rice-eclipse/Real-Time-Rocket/Neutro_documentation/Neutro Kicad Symbol Footprint/畫面截取 2022-11-02 at 14.26.27.png

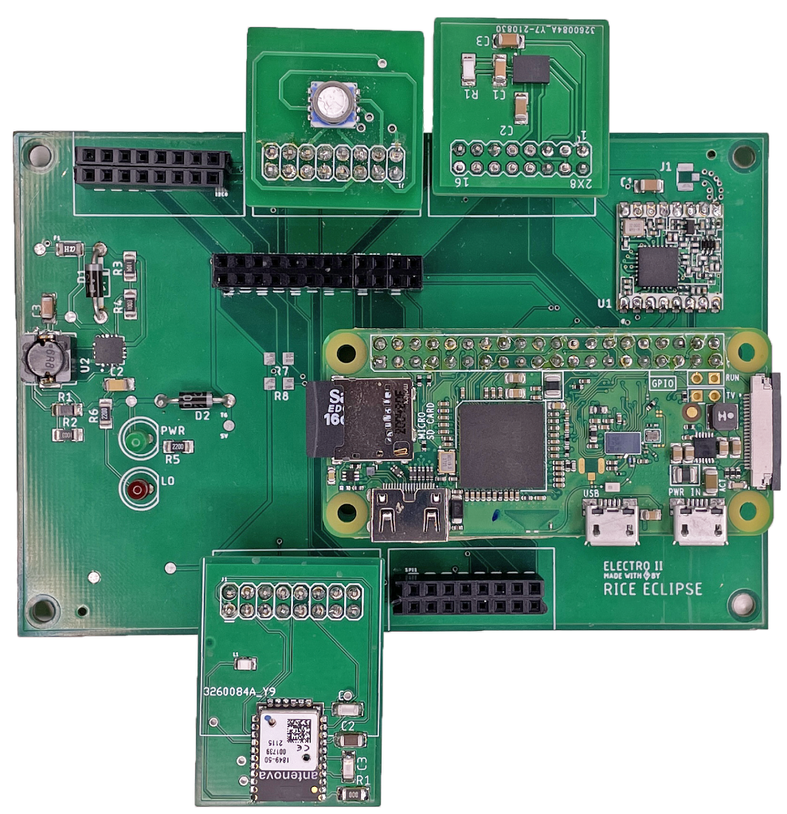
Neutro_documentation/Neutro Kicad Symbol Footprint/畫面截取 2022-11-02 at 14.26.27.png
