rice-eclipse/Real-Time-Rocket/Neutro_documentation/主題.jpeg

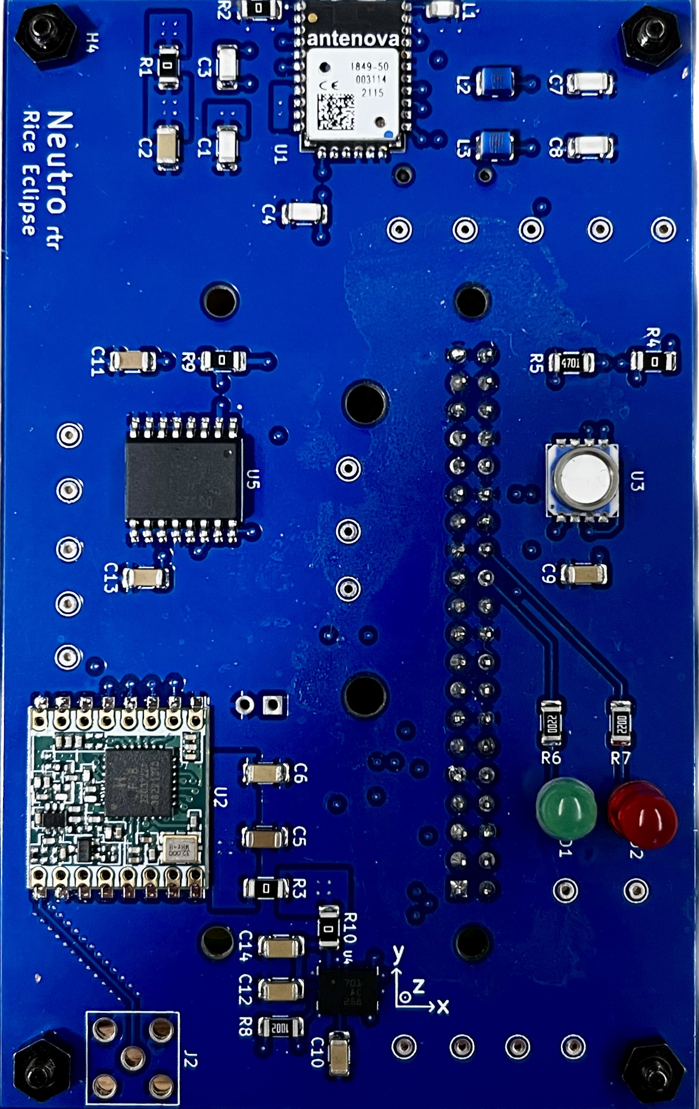
Neutro_documentation/主題.jpeg
