rice-eclipse/Real-Time-Rocket/README.md

# Neutro
Third iteration of Rice Eclipse's student developed flight computer Real Time Rocket. Includes PCB design files and python scripts used to operate Neutro sensors and transmit data to the ground station NARWAL.
