rice-eclipse/Real-Time-Rocket/Neutro_documentation/GPS/畫面截取 2023-03-22 at 22.20.59.png

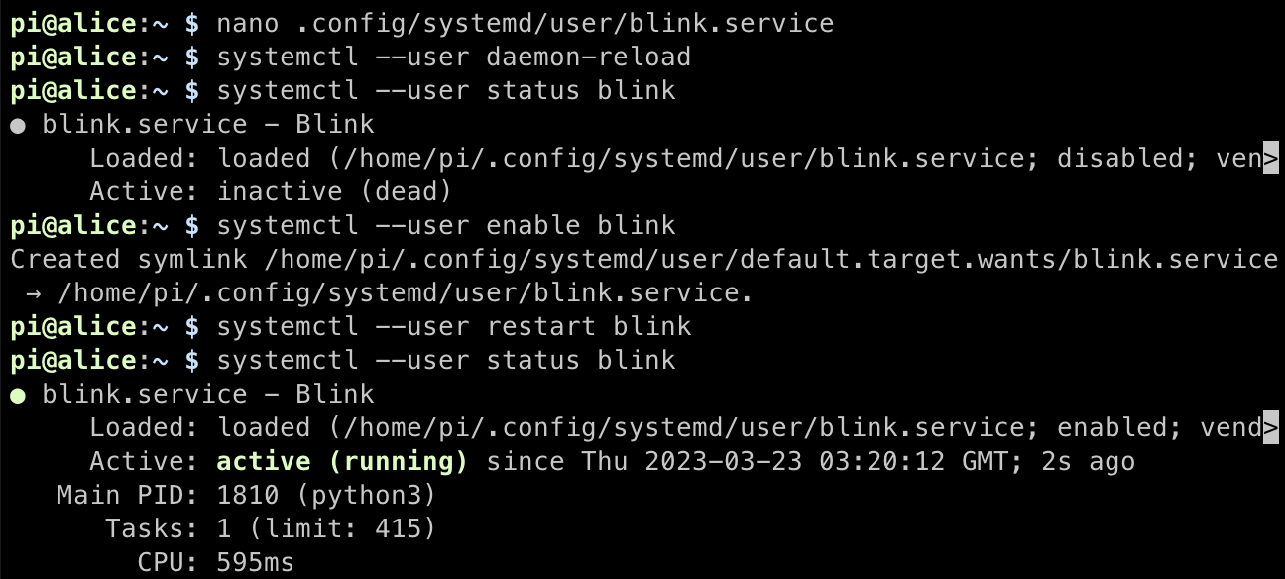
Neutro_documentation/GPS/畫面截取 2023-03-22 at 22.20.59.png
