rice-eclipse/Real-Time-Rocket/Neutro_documentation/JLC Order Settings/screentshot1.png

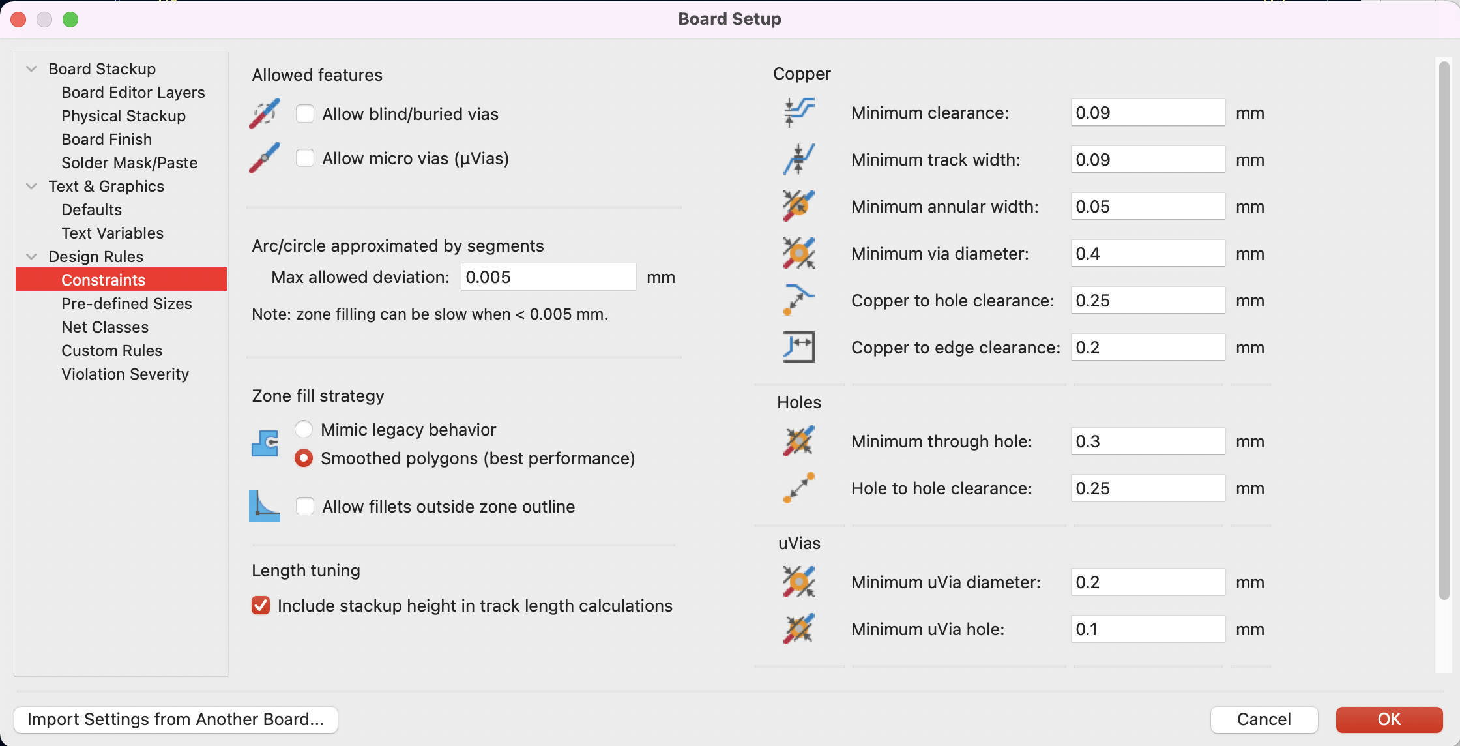
Neutro_documentation/JLC Order Settings/screentshot1.png
