rice-eclipse/Real-Time-Rocket/Neutro_documentation/JLC Order Settings/screentshot3.png

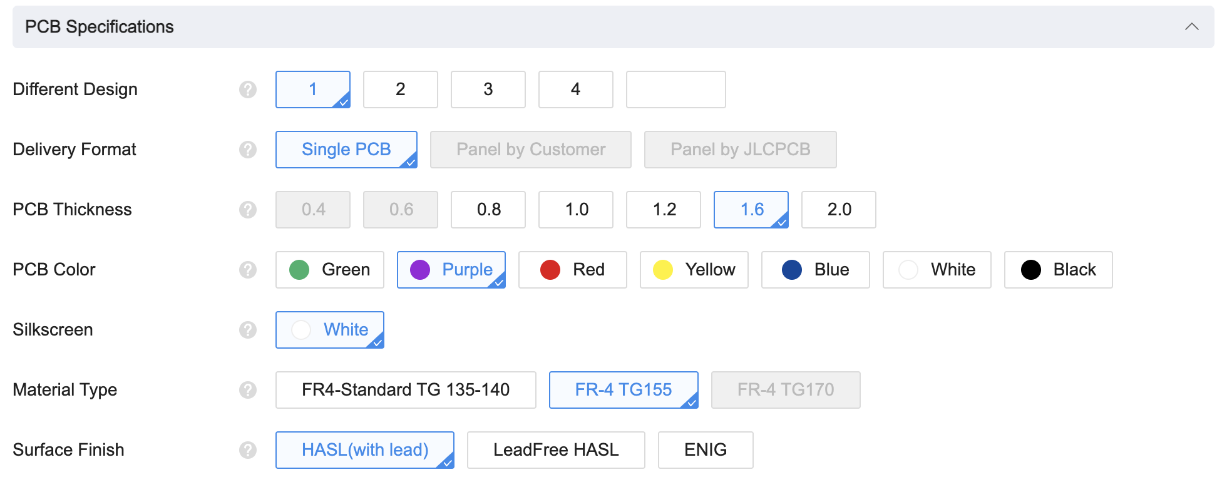
Neutro_documentation/JLC Order Settings/screentshot3.png
