rice-eclipse/Real-Time-Rocket/Neutro_documentation/JLC Order Settings/screentshot4.png

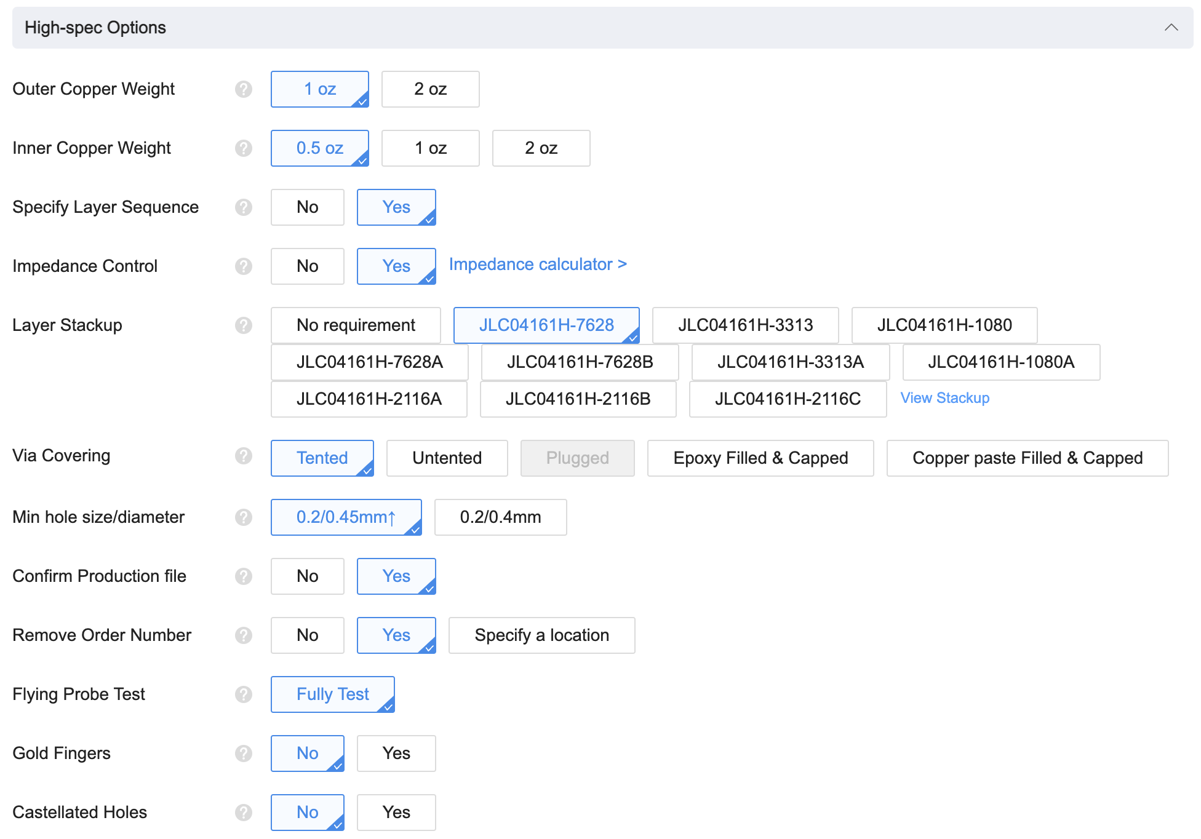
Neutro_documentation/JLC Order Settings/screentshot4.png
