rice-eclipse/Real-Time-Rocket/Neutro_documentation/Neutro Kicad Symbol Footprint/BNO080/BNO080.step

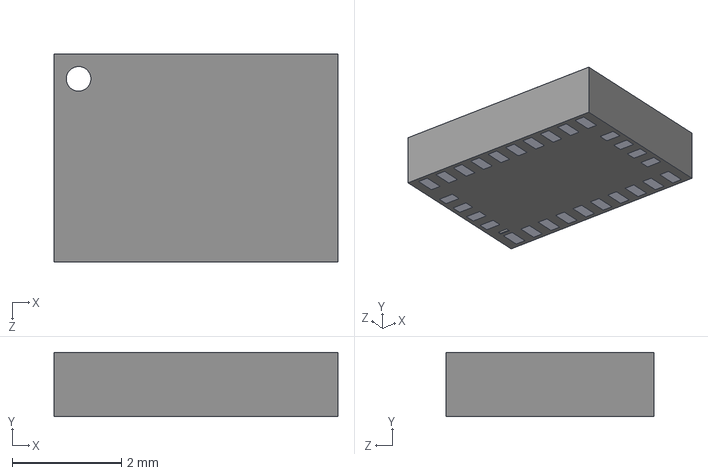
[picture p7: CAD file, 2023-06-26]
Neutro_documentation/Neutro Kicad Symbol Footprint/BNO080/BNO080.step
5.20 x 1.18 x 3.80 mm
