rice-eclipse/Real-Time-Rocket/Neutro_documentation/Neutro Kicad Symbol Footprint/DS3231M_TRL/DS3231M_TRL.step

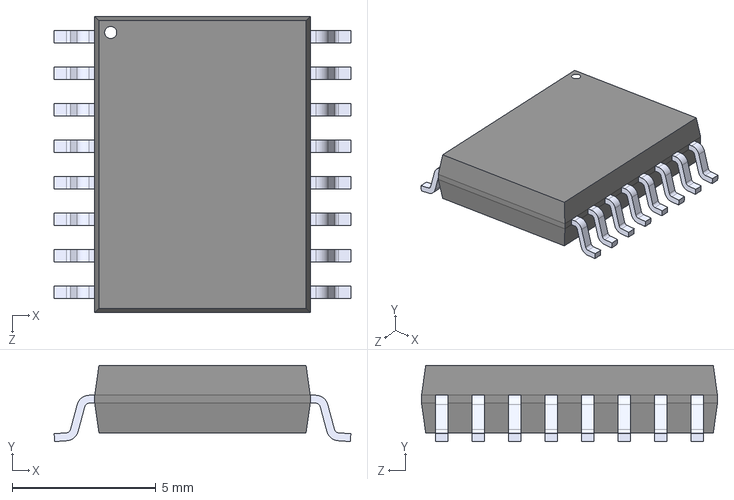
[picture p8: CAD file, 2023-01-18]
Neutro_documentation/Neutro Kicad Symbol Footprint/DS3231M_TRL/DS3231M_TRL.step
10.3 x 2.65 x 10.3 mm
