rice-eclipse/Real-Time-Rocket/Neutro_documentation/Neutro Kicad Symbol Footprint/RFM98W-433S2 copy/RFM98W-433S2.step

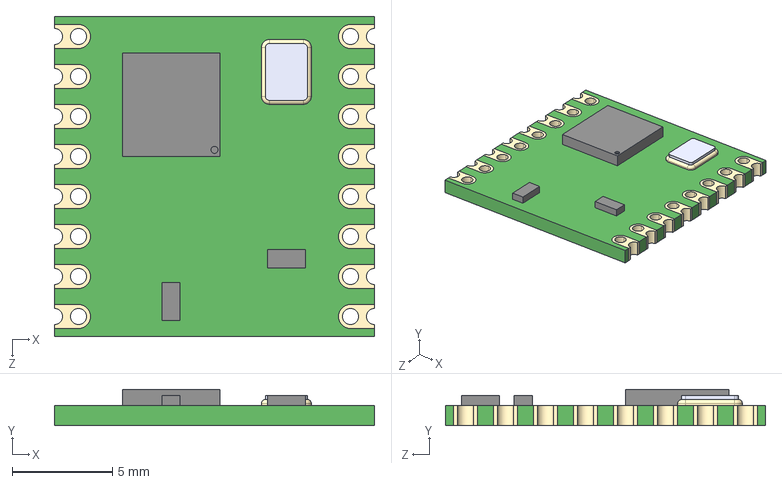
[picture p9: CAD file, 2023-06-26]
Neutro_documentation/Neutro Kicad Symbol Footprint/RFM98W-433S2 copy/RFM98W-433S2.step
16.0 x 1.80 x 16.0 mm
