rice-eclipse/Real-Time-Rocket/Neutro_documentation/Neutro Kicad Symbol Footprint/S8411-45R/S8411-45R.step

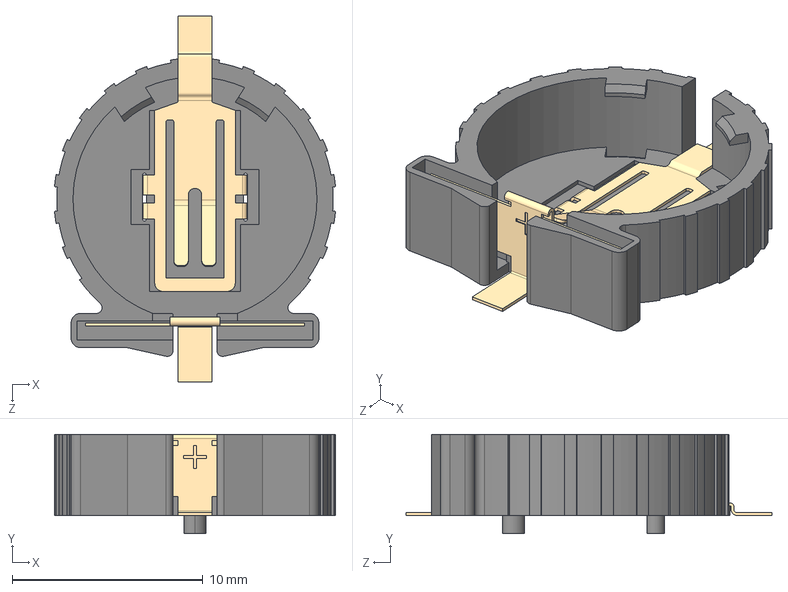
[picture p10: CAD file, 2023-06-26]
Neutro_documentation/Neutro Kicad Symbol Footprint/S8411-45R/S8411-45R.step
14.7 x 5.20 x 19.2 mm
