rice-eclipse/Real-Time-Rocket/Neutro_PCB/Neutro_3D_Files/BNO085.stp

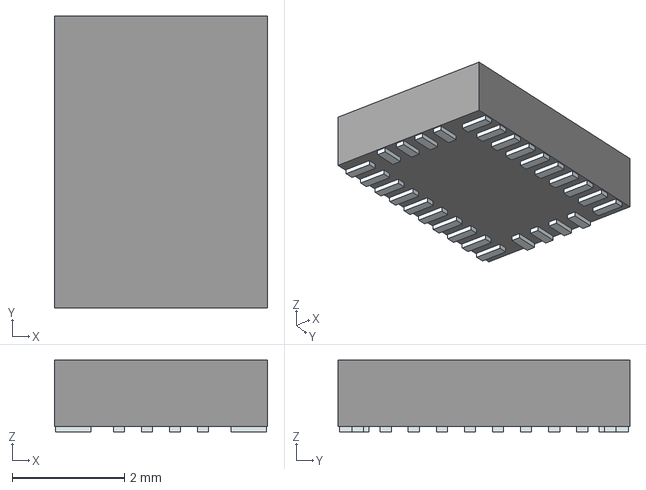
[picture p11: CAD file, 2023-01-18]
Neutro_PCB/Neutro_3D_Files/BNO085.stp
3.80 x 5.20 x 1.28 mm
Pins
