rice-eclipse/Real-Time-Rocket/Neutro_PCB/Neutro_3D_Files/RFM95W-868S2--3DModel-STEP-56544.step

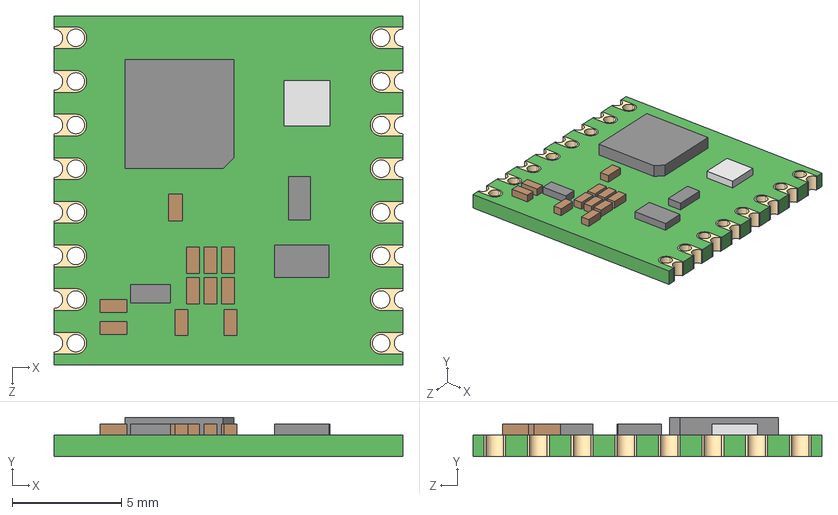
[picture p12: CAD file, 2023-01-18]
Neutro_PCB/Neutro_3D_Files/RFM95W-868S2--3DModel-STEP-56544.step
16.0 x 1.80 x 16.0 mm
