rice-eclipse/Real-Time-Rocket/Neutro_documentation/Neutro Kicad Symbol Footprint/TPS61092RSAR/TPS61092RSAR.step

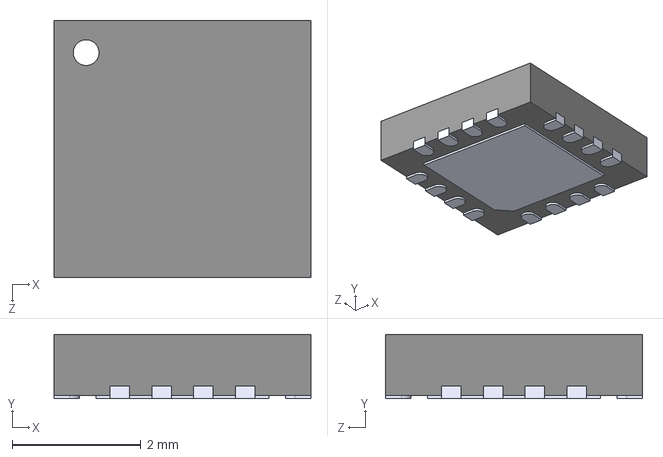
[picture p13: CAD file, 2023-06-26]
Neutro_documentation/Neutro Kicad Symbol Footprint/TPS61092RSAR/TPS61092RSAR.step
4.00 x 1.00 x 4.00 mm
