rice-eclipse/Real-Time-Rocket/Neutro_PCB/Neutro_Extra_Lib/M20050-1_Lib/M20050-1/3D/M20050-1.stp

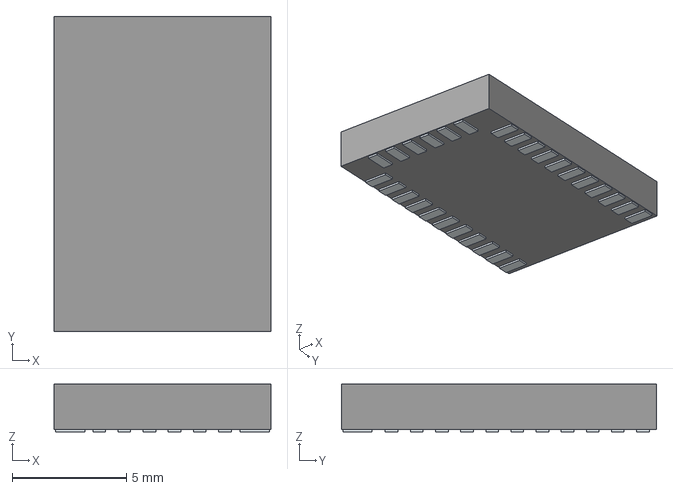
[picture p14: CAD file, 2023-01-18]
Neutro_PCB/Neutro_Extra_Lib/M20050-1_Lib/M20050-1/3D/M20050-1.stp
9.50 x 13.8 x 2.10 mm
Pins
