rice-eclipse/Real-Time-Rocket/Neutro_PCB/Neutro_Extra_Lib/MS580330BA01-00_Lib/MS580330BA01-00/3D/MS580330BA01-00.stp

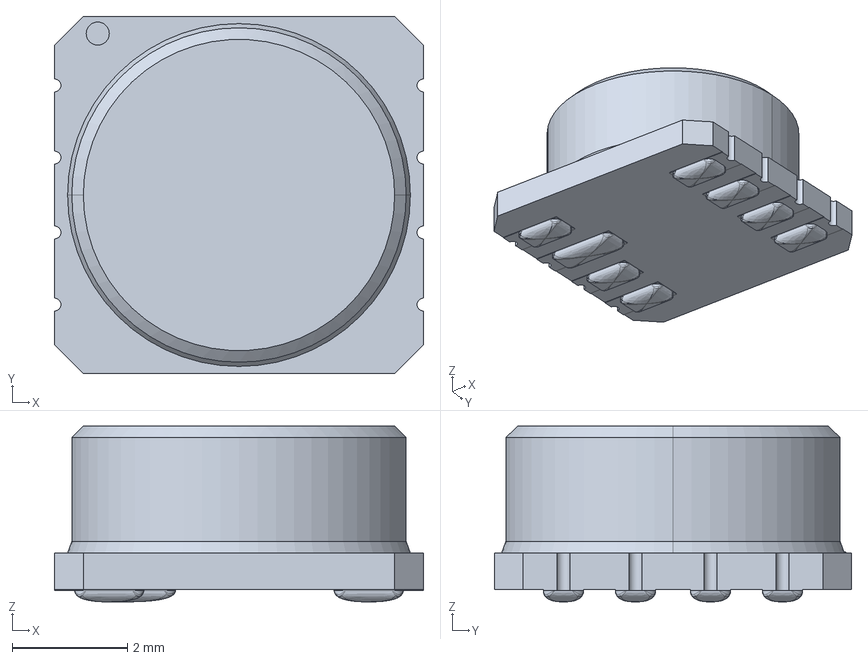
[picture p15: CAD file, 2023-01-18]
Neutro_PCB/Neutro_Extra_Lib/MS580330BA01-00_Lib/MS580330BA01-00/3D/MS580330BA01-00.stp
6.40 x 6.20 x 3.05 mm
