rice-eclipse/Real-Time-Rocket/(list of files, cad)

Other CAD files:
Neutro_PCB/Neutro_3D_Files/BATT-S8411-45R.step
Neutro_PCB/Neutro_Extra_Lib/BNO085_Lib/BNO085/Allegro/bno085.psm
Neutro_PCB/Neutro_Extra_Lib/BNO085_Lib/BNO085/DEHDL/bno085/chips/chips.prt
Neutro_PCB/Neutro_Extra_Lib/M20050-1_Lib/M20050-1/Allegro/m200501.psm
Neutro_PCB/Neutro_Extra_Lib/M20050-1_Lib/M20050-1/DEHDL/m20050_1/chips/chips.prt
Neutro_PCB/Neutro_Extra_Lib/MS580330BA01-00_Lib/MS580330BA01-00/Allegro/ms580330ba0100.psm
Neutro_PCB/Neutro_Extra_Lib/MS580330BA01-00_Lib/MS580330BA01-00/DEHDL/ms580330ba01_00/chips/chips.prt
