rice-eclipse/Real-Time-Rocket/(list of files, drawings)

Other design files:
Neutro_PCB/Neutro_Extra_Lib/BNO085_Lib/BNO085/Altium/BNO085.PcbLib
Neutro_PCB/Neutro_Extra_Lib/BNO085_Lib/BNO085/Altium/BNO085.SchLib
Neutro_PCB/Neutro_Extra_Lib/M20050-1_Lib/M20050-1/Altium/M20050-1.SchLib
Neutro_PCB/Neutro_Extra_Lib/M20050-1_Lib/M20050-1/Altium/M200501.PcbLib
Neutro_PCB/Neutro_Extra_Lib/MS580330BA01-00_Lib/MS580330BA01-00/Altium/MS580330BA01-00.SchLib
Neutro_PCB/Neutro_Extra_Lib/MS580330BA01-00_Lib/MS580330BA01-00/Altium/MS580330BA0100.PcbLib
