rice-eclipse/Real-Time-Rocket/Neutro_PCB/Neutro_v1.kicad_pcb

## KiCad design Neutro_PCB/Neutro_v1.kicad_pcb (2023-01-22)

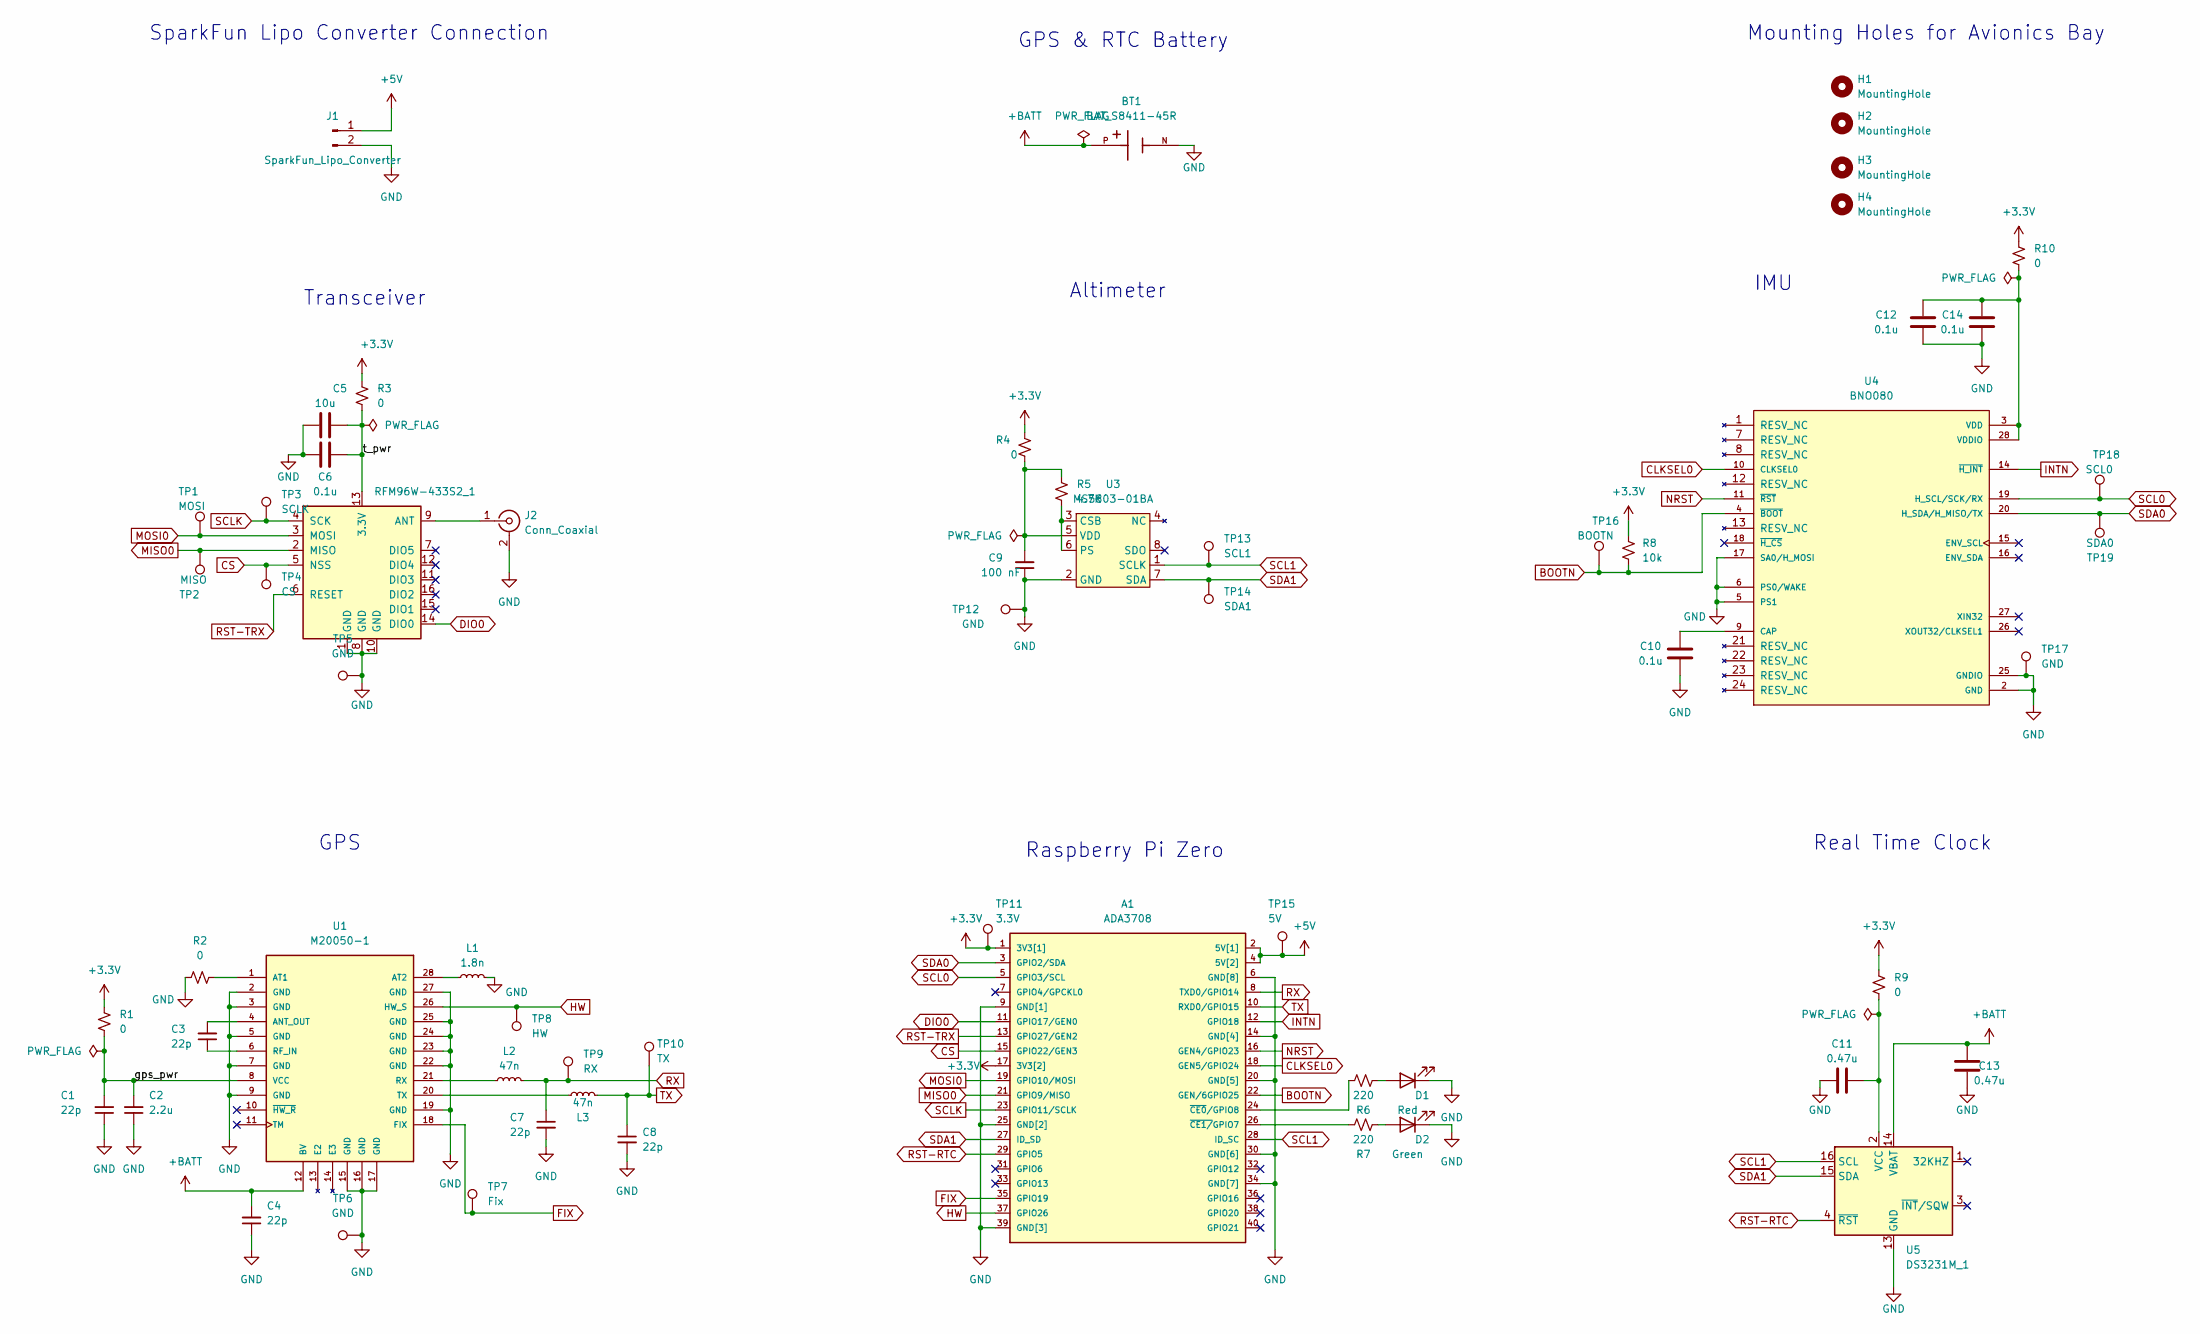
[picture p16: schematic Neutro_v1.kicad_sch, Neutro]

Parts:
A1: ADA3708; ADA3708_RPI-ZERO
BT1: BAT_S8411-45R
C1, C3, C4, C7, C8: 22p; C_1206_3216Metric
C2: 2.2u; C_1206_3216Metric
C5: 10u; C_1206_3216Metric
C6, C10, C12, C14: 0.1u; C_1206_3216Metric
C9: 100 nF; C_1206_3216Metric
C11, C13: 0.47u; C_1206_3216Metric
D1: Red; LED_D3.0mm
D2: Green; LED_D3.0mm
H1, H2, H3, H4: MountingHole; MountingHole_2.5mm
J1: SparkFun_Lipo_Converter; Sparkfun_Lipo_Converter
J2: Conn_Coaxial; SMA_Amphenol_132203-12_Horizontal
L1: 1.8n; L_0805_2012Metric
L2, L3: 47n; L_1008_2520Metric
R1, R2, R3, R4, R9, R10: 0; R_1206_3216Metric
R5: 4.7K; R_1206_3216Metric
R6, R7: 220; R_1206_3216Metric
R8: 10k; R_1206_3216Metric
TP1: MOSI; TestPoint_THTPad_D1.5mm_Drill0.7mm
TP2: MISO; TestPoint_THTPad_D1.5mm_Drill0.7mm
TP3: SCLK; TestPoint_THTPad_D1.5mm_Drill0.7mm
TP4: CS; TestPoint_THTPad_D1.5mm_Drill0.7mm
TP5, TP6, TP12, TP17: GND; TestPoint_THTPad_D1.5mm_Drill0.7mm
TP7: Fix; TestPoint_THTPad_D1.5mm_Drill0.7mm
TP8: HW; TestPoint_THTPad_D1.5mm_Drill0.7mm
TP9: RX; TestPoint_THTPad_D1.5mm_Drill0.7mm
TP10: TX; TestPoint_THTPad_D1.5mm_Drill0.7mm
TP11: 3.3V; TestPoint_THTPad_D1.5mm_Drill0.7mm
TP13: SCL1; TestPoint_THTPad_D1.5mm_Drill0.7mm
TP14: SDA1; TestPoint_THTPad_D1.5mm_Drill0.7mm
TP15: 5V; TestPoint_THTPad_D1.5mm_Drill0.7mm
TP16: BOOTN; TestPoint_THTPad_D1.5mm_Drill0.7mm
TP18: SCL0; TestPoint_THTPad_D1.5mm_Drill0.7mm
TP19: SDA0; TestPoint_THTPad_D1.5mm_Drill0.7mm
U1: M20050-1; PARTREV M20050-1-PS-2.01
U2: RFM96W-433S2_1; HOPERF_RFM9XW_SMD
U3: MS5803-01BA; MS5803-01BA_Miniature_Altimeter_Module
U4: BNO080; BNO085; PARTREV 1.6
U5: DS3231M_1; DS3231M

Connections:
+3.3V: A1.1 (3V3[1]), A1.17 (3V3[2]), R1.1, R3.1, R4.1, R8.1, R9.1, R10.1, TP11.1
+5V: A1.2 (5V[1]), A1.4 (5V[2]), J1.1, TP15.1
+BATT: BT1.P, C4.2, C13.1, U1.12 (BV), U5.14 (VBAT)
/gps_pwr: C1.2, C2.2, R1.2, U1.8 (VCC)
/t_pwr: C5.2, C6.2, R3.2, U2.13 (3.3V)
BOOTN: A1.22 (GEN/6GPIO25), R8.2, TP16.1, U4.4 (~BOOT)
CLKSEL0: A1.18 (GEN5/GPIO24), U4.10 (CLKSEL0)
CS: A1.15 (GPIO22/GEN3), TP4.1, U2.5 (NSS)
DIO0: A1.11 (GPIO17/GEN0), U2.14 (DIO0)
FIX: A1.35 (GPIO19), TP7.1, U1.18 (FIX)
GND: A1.6 (GND[8]), A1.9 (GND[1]), A1.14 (GND[4]), A1.20 (GND[5]), A1.25 (GND[2]), A1.30 (GND[6]), A1.34 (GND[7]), A1.39 (GND[3]), BT1.N, C1.1, C2.1, C4.1, C5.1, C6.1, C7.2, C8.2, C9.1, C10.1, C11.1, C12.1, C13.2, C14.1, D1.1 (K), D2.1 (K), J1.2, J2.2 (Ext), L1.1, R2.1, TP5.1, TP6.1, TP12.1, TP17.1, U1.2 (GND), U1.3 (GND), U1.5 (GND), U1.7 (GND), U1.9 (GND), U1.15 (GND), U1.16 (GND), U1.17 (GND), U1.19 (GND), U1.22 (GND), U1.23 (GND), U1.24 (GND), U1.25 (GND), U1.27 (GND), U2.1 (GND), U2.8 (GND), U2.10 (GND), U3.2 (GND), U4.2 (GND), U4.5 (PS1), U4.6 (PS0/WAKE), U4.17 (SA0/H_MOSI), U4.25 (GNDIO), U5.5 (GND), U5.6 (GND), U5.7 (GND), U5.8 (GND), U5.9 (GND), U5.10 (GND), U5.11 (GND), U5.12 (GND), U5.13 (GND)
HW: A1.37 (GPIO26), TP8.1, U1.26 (HW_S)
INTN: A1.12 (GPIO18), U4.14 (~H_INT)
MISO0: A1.21 (GPIO9/MISO), TP2.1, U2.2 (MISO)
MOSI0: A1.19 (GPIO10/MOSI), TP1.1, U2.3 (MOSI)
NRST: A1.16 (GEN4/GPIO23), U4.11 (~RST)
unnamed: A1.24 (~CE0/GPIO8), R6.1
unnamed: A1.26 (~CE1/GPIO7), R7.1
unnamed: C3.1, U1.6 (RF_IN)
unnamed: C3.2, U1.4 (ANT_OUT)
unnamed: C9.2, R4.2, R5.1, U3.5 (VDD)
unnamed: C10.2, U4.9 (CAP)
unnamed: C11.2, R9.2, U5.2 (VCC)
unnamed: C12.2, C14.2, R10.2, U4.3 (VDD), U4.28 (VDDIO)
unnamed: D1.2 (A), R6.2
unnamed: D2.2 (A), R7.2
unnamed: J2.1 (In), U2.9 (ANT)
unnamed: L1.2, U1.28 (AT2)
unnamed: L2.1, U1.21 (RX)
unnamed: L3.1, U1.20 (TX)
unnamed: R2.2, U1.1 (AT1)
unnamed: R5.2, U3.3 (CSB), U3.6 (PS)
RST-RTC: A1.29 (GPIO5), U5.4 (~RST)
RST-TRX: A1.13 (GPIO27/GEN2), U2.6 (RESET)
RX: A1.8 (TXD0/GPIO14), C7.1, L2.2, TP9.1
SCL0: A1.5 (GPIO3/SCL), TP18.1, U4.19 (H_SCL/SCK/RX)
SCL1: A1.28 (ID_SC), TP13.1, U3.1 (SCLK), U5.16 (SCL)
SCLK: A1.23 (GPIO11/SCLK), TP3.1, U2.4 (SCK)
SDA0: A1.3 (GPIO2/SDA), TP19.1, U4.20 (H_SDA/H_MISO/TX)
SDA1: A1.27 (ID_SD), TP14.1, U3.7 (SDA), U5.15 (SDA)
TX: A1.10 (RXD0/GPIO15), C8.1, L3.2, TP10.1

Notes on the sheet:
IMU
Raspberry Pi Zero
GPS & RTC Battery
SparkFun Lipo Converter Connection
GPS
Altimeter
Real Time Clock
Transceiver
Mounting Holes for Avionics Bay

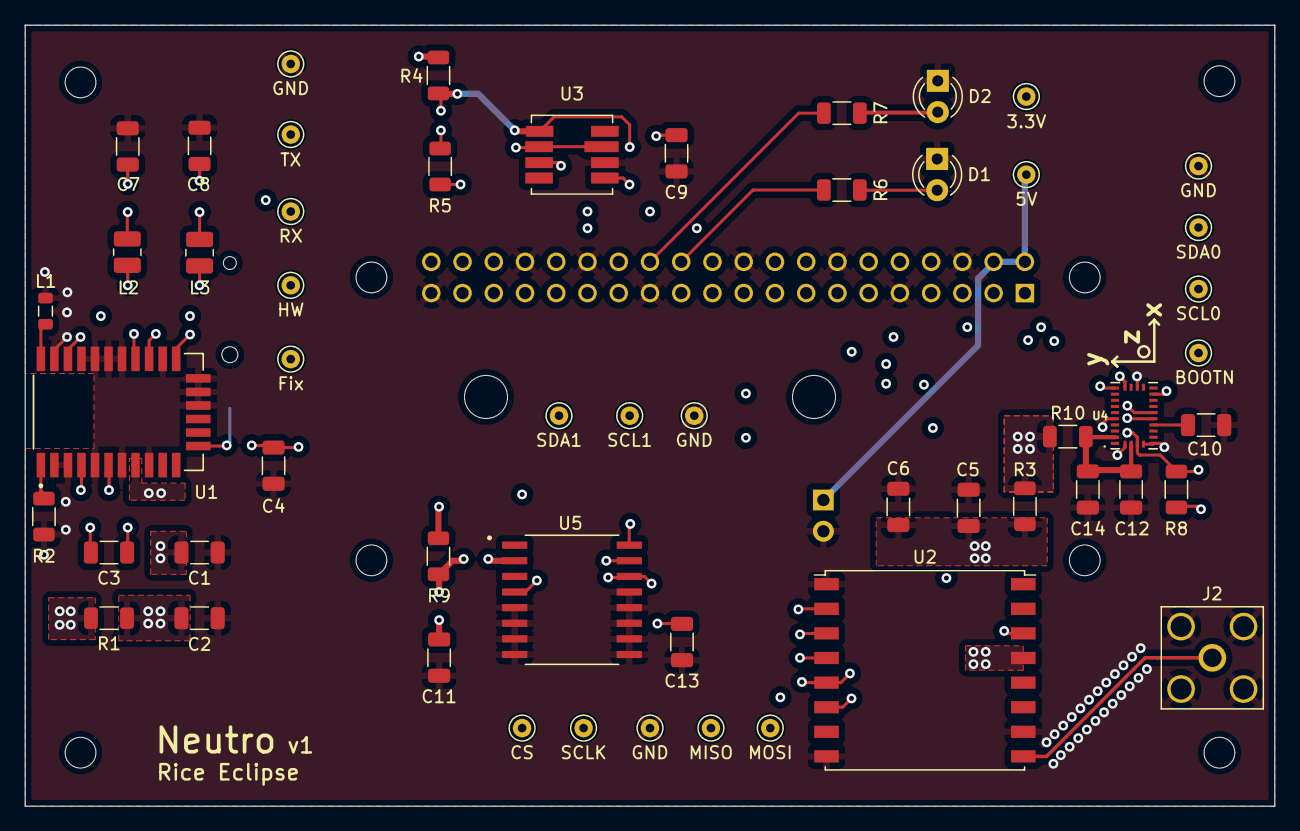
[picture p17: board Neutro_v1.kicad_pcb from above]

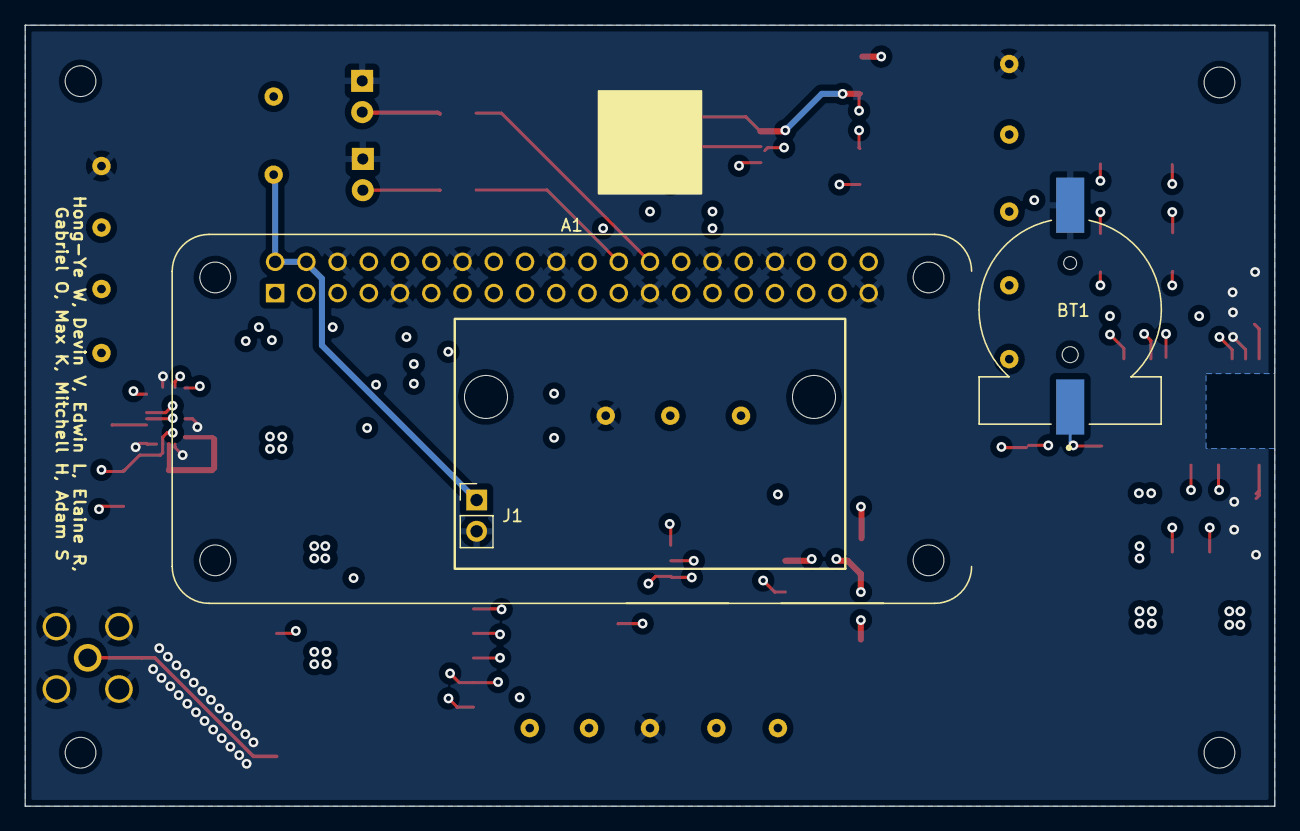
[picture p18: board Neutro_v1.kicad_pcb from below]

Board: 4 copper layers, 101.6 x 63.5 mm, 61 parts (3 on the bottom side), 41 nets.
