rice-eclipse/Real-Time-Rocket/Neutro_documentation/Neutro Kicad Symbol Footprint/Electro Transmitter Rev 1 copy.brd

## EAGLE design Neutro_documentation/Neutro Kicad Symbol Footprint/Electro Transmitter Rev 1 copy.brd (2019-08-31)

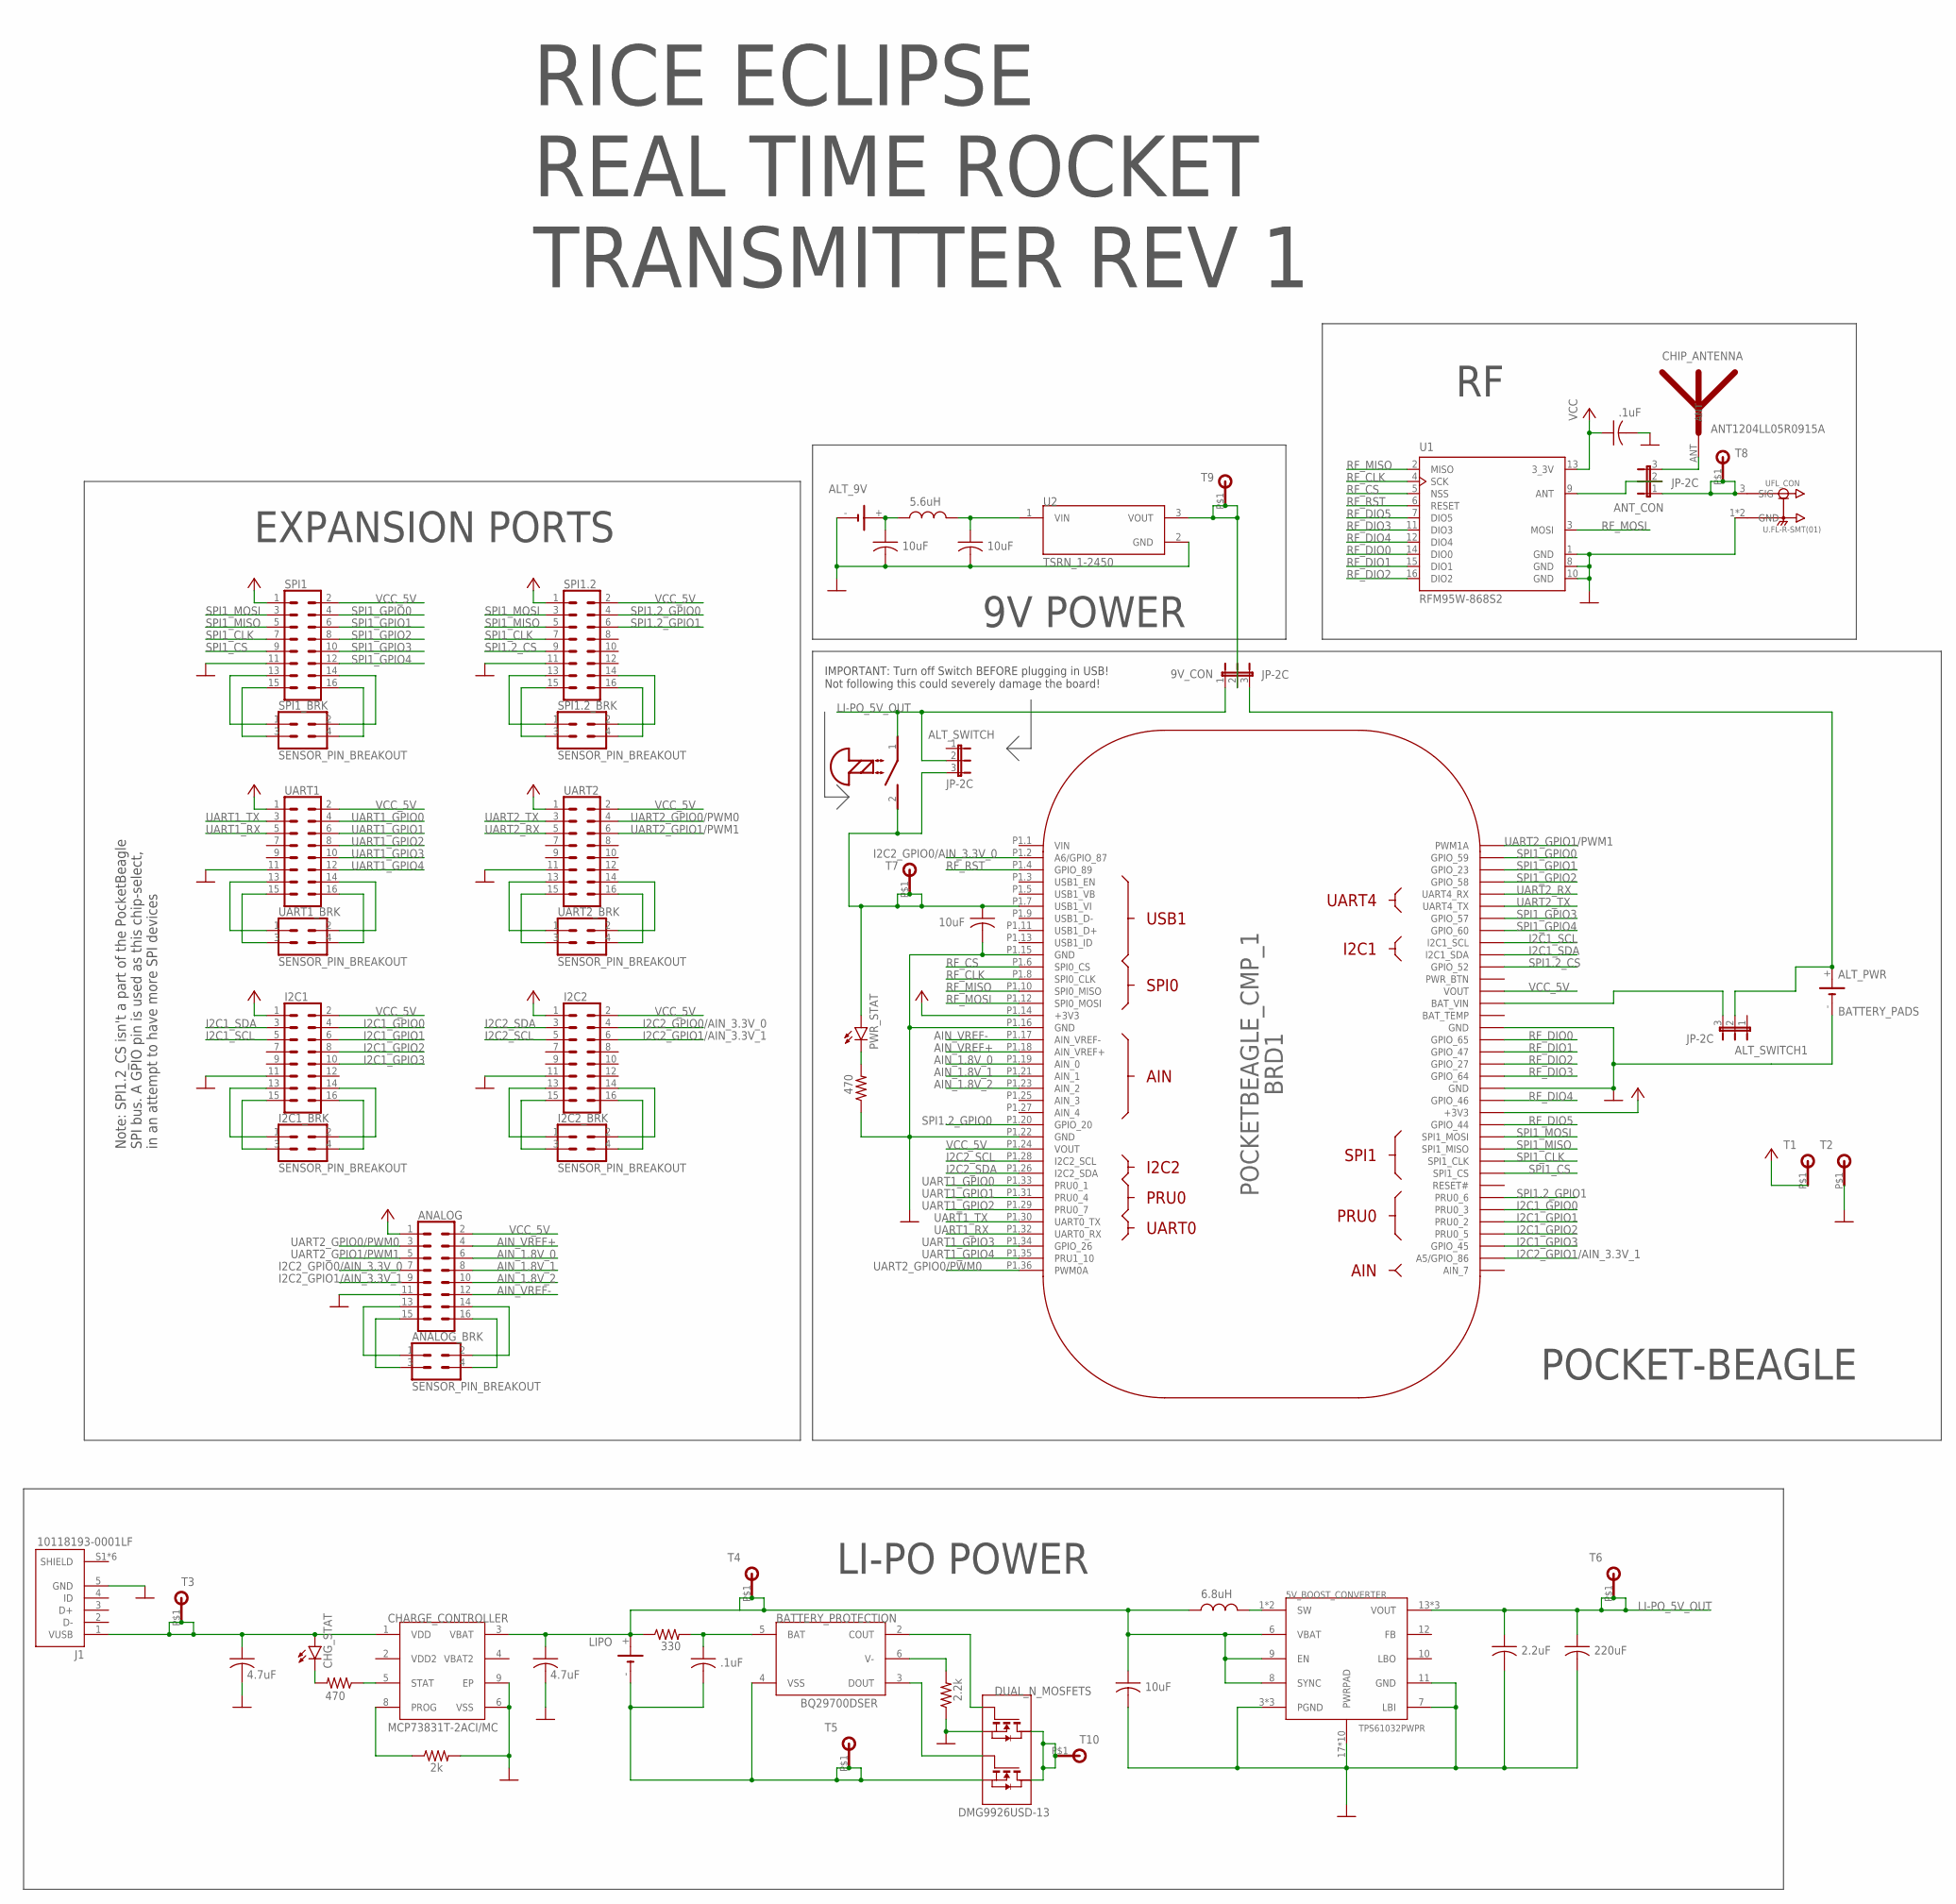
[picture p19: schematic Electro Transmitter Rev 1 copy.sch]

Parts:
5V_BOOST_CONVERTER: TPS61032PWPR; SOP65P640X110-17N
9V_C1, 9V_C2: 10uF; C1206
9V_CON: JP-2C; JP2
9V_L1: 5.6uH; L-DS75LC
ALT_9V: BATTERY_PADS; POWER_PADS
ALT_PWR: BATTERY_PADS; POWER_PADS
ALT_SWITCH, ALT_SWITCH1: JP-2C; JP2
ANALOG: 2X6 FEMALE; 2X7
ANALOG_BRK: SENSOR_PIN_BREAKOUT; 2X2
ANT_CON: JP-2C; JP2
BATTERY_PROTECTION: BQ29700DSER; SON50P150X150X80-6N
BAT_C1: .1uF; C1206
BAT_PWR: SCREW_SWITCH
BAT_R1: 330; R1206
BAT_R2: 2.2k; R1206
BRD1: POCKETBEAGLE_CMP_1; POCKETBEAGLE_CMP
CHARGE_CONTROLLER: MCP73831T-2ACI/MC; SON50P200X300X100-9N
CHG_C1, CHG_C2: 4.7uF; C1206
CHG_R1: 470; R1206
CHG_R2: 2k; R1206
CHG_STAT: LED5MM
CHIP_ANTENNA: ANT1204LL05R0915A; SMD_ANTENNA
CONV_C1: 10uF; C1206
CONV_C2: 2.2uF; C1206
CONV_C3: 220uF; C1206
CONV_L1: 6.8uH; L-DS75LC
DUAL_N_MOSFETS: DMG9926USD-13; SOIC127P600X175-8N
I2C1, I2C2: 2X6 FEMALE; 2X7
I2C1_BRK, I2C2_BRK: SENSOR_PIN_BREAKOUT; 2X2
J1: 10118193-0001LF; FCI_10118193-0001LF
LED_R_1: 470; R1206
LIPO: BATTERY_PADS; POWER_PADS
PWR_C1: 10uF; C1206
PWR_STAT: LED5MM
RF_C1: .1uF; C1206
SPI1, SPI1.2: 2X6 FEMALE; 2X7
SPI1.2_BRK, SPI1_BRK: SENSOR_PIN_BREAKOUT; 2X2
T1, T2, T3, T4, T5, T6, T7, T8, T9, T10: TEST_PAD
U1: RFM95W-868S2; XCVR_RFM95W-868S2
U2: TSRN_1-2450; CONV_TSRN_1-2433
UART1, UART2: 2X6 FEMALE; 2X7
UART1_BRK, UART2_BRK: SENSOR_PIN_BREAKOUT; 2X2
UFL_CON: U.FL-R-SMT(01); HRS_U.FL-R-SMT(01)

Connections:
9V_+: 9V_C1.1, 9V_L1.P$1 (1), ALT_9V.+
9V_VIN: 9V_C2.1, 9V_L1.P$2 (2), U2.1 (VIN)
9V_VOUT: 9V_CON.2, T9.P$1, U2.3 (VOUT)
AIN_1.8V_0: ANALOG.6, BRD1.P1.19 (AIN_0)
AIN_1.8V_1: ANALOG.8, BRD1.P1.21 (AIN_1)
AIN_1.8V_2: ANALOG.10, BRD1.P1.23 (AIN_2)
AIN_VREF+: ANALOG.4, BRD1.P1.18 (AIN_VREF+)
AIN_VREF-: ANALOG.12, BRD1.P1.17 (AIN_VREF-)
ALT_PWR_+: 9V_CON.3, ALT_PWR.+, ALT_SWITCH1.2
ANT: ANT_CON.3, CHIP_ANTENNA.ANT
BAT: BATTERY_PROTECTION.5 (BAT), BAT_C1.1, BAT_R1.2
BAT_VIN: ALT_SWITCH1.3, BRD1.P2.14 (BAT_VIN)
COUT: BATTERY_PROTECTION.2 (COUT), DUAL_N_MOSFETS.2 (G1)
DOUT: BATTERY_PROTECTION.3 (DOUT), DUAL_N_MOSFETS.4 (G2)
DRAIN: DUAL_N_MOSFETS.5 (D2), DUAL_N_MOSFETS.6 (D2), DUAL_N_MOSFETS.7 (D1), DUAL_N_MOSFETS.8 (D1), T10.P$1
GND: 5V_BOOST_CONVERTER.3 (PGND), 5V_BOOST_CONVERTER.4 (PGND), 5V_BOOST_CONVERTER.5 (PGND), 5V_BOOST_CONVERTER.7 (LBI), 5V_BOOST_CONVERTER.11 (GND), 5V_BOOST_CONVERTER.17 (PWRPAD), 5V_BOOST_CONVERTER.P$1 (PWRPAD), 5V_BOOST_CONVERTER.P$2 (PWRPAD), 5V_BOOST_CONVERTER.P$3 (PWRPAD), 5V_BOOST_CONVERTER.P$4 (PWRPAD), 5V_BOOST_CONVERTER.P$5 (PWRPAD), 5V_BOOST_CONVERTER.P$6 (PWRPAD), 5V_BOOST_CONVERTER.P$7 (PWRPAD), 5V_BOOST_CONVERTER.P$8 (PWRPAD), 5V_BOOST_CONVERTER.P$9 (PWRPAD), 9V_C1.2, 9V_C2.2, ALT_9V.-, ALT_PWR.-, ANALOG.11, BAT_R2.1, BRD1.P1.15 (GND), BRD1.P1.16 (GND), BRD1.P1.22 (GND), BRD1.P2.15 (GND), BRD1.P2.21 (GND), CHARGE_CONTROLLER.6 (VSS), CHARGE_CONTROLLER.9 (EP), CHG_C1.2, CHG_C2.2, CHG_R2.2, CONV_C1.2, CONV_C2.2, CONV_C3.2, DUAL_N_MOSFETS.1 (S1), I2C1.11, I2C2.11, J1.5 (GND), LED_R_1.1, PWR_C1.2, RF_C1.2, SPI1.11, SPI1.2.11, T2.P$1, U1.1 (GND), U1.8 (GND), U1.10 (GND), U2.2 (GND), UART1.11, UART2.11, UFL_CON.1 (GND), UFL_CON.2 (GND)
I2C1_GPIO0: BRD1.P2.30 (PRU0_3), I2C1.4
I2C1_GPIO1: BRD1.P2.32 (PRU0_2), I2C1.6
I2C1_GPIO2: BRD1.P2.34 (PRU0_5), I2C1.8
I2C1_GPIO3: BRD1.P2.33 (GPIO_45), I2C1.10
I2C1_SCL: BRD1.P2.9 (I2C1_SCL), I2C1.5
I2C1_SDA: BRD1.P2.11 (I2C1_SDA), I2C1.3
I2C2_GPIO0/AIN_3.3V_0: ANALOG.7, BRD1.P1.2 (A6/GPIO_87), I2C2.4
I2C2_GPIO1/AIN_3.3V_1: ANALOG.9, BRD1.P2.35 (A5/GPIO_86), I2C2.6
I2C2_SCL: BRD1.P1.28 (I2C2_SCL), I2C2.5
I2C2_SDA: BRD1.P1.26 (I2C2_SDA), I2C2.3
LED: LED_R_1.2, PWR_STAT.K (C)
LED-: CHG_R1.2, CHG_STAT.K (C)
LI-PO_5V_OUT: 5V_BOOST_CONVERTER.13 (VOUT), 5V_BOOST_CONVERTER.14 (VOUT), 5V_BOOST_CONVERTER.15 (VOUT), 9V_CON.1, ALT_SWITCH.2, BAT_PWR.1 (2), CONV_C2.1, CONV_C3.1, T6.P$1
LI-PO_+: 5V_BOOST_CONVERTER.6 (VBAT), 5V_BOOST_CONVERTER.8 (SYNC), 5V_BOOST_CONVERTER.9 (EN), BAT_R1.1, CHARGE_CONTROLLER.3 (VBAT), CHG_C2.1, CONV_C1.1, CONV_L1.P$1 (1), LIPO.+, T4.P$1
LI-PO_-: BATTERY_PROTECTION.4 (VSS), BAT_C1.2, DUAL_N_MOSFETS.3 (S2), LIPO.-, T5.P$1
unnamed: ANT_CON.1, T8.P$1, UFL_CON.3 (SIG)
unnamed: 5V_BOOST_CONVERTER.1 (SW), 5V_BOOST_CONVERTER.2 (SW), CONV_L1.P$2 (2)
unnamed: SPI1.14, SPI1_BRK.2
unnamed: SPI1.13, SPI1_BRK.1
unnamed: SPI1.15, SPI1_BRK.3
unnamed: SPI1.16, SPI1_BRK.4
unnamed: SPI1.2.13, SPI1.2_BRK.1
unnamed: SPI1.2.14, SPI1.2_BRK.2
unnamed: SPI1.2.16, SPI1.2_BRK.4
unnamed: SPI1.2.15, SPI1.2_BRK.3
unnamed: UART1.13, UART1_BRK.1
unnamed: UART1.15, UART1_BRK.3
unnamed: UART1.14, UART1_BRK.2
unnamed: UART1.16, UART1_BRK.4
unnamed: UART2.15, UART2_BRK.3
unnamed: UART2.16, UART2_BRK.4
unnamed: UART2.14, UART2_BRK.2
unnamed: UART2.13, UART2_BRK.1
unnamed: I2C1.16, I2C1_BRK.4
unnamed: I2C1.15, I2C1_BRK.3
unnamed: I2C1.13, I2C1_BRK.1
unnamed: I2C1.14, I2C1_BRK.2
unnamed: I2C2.15, I2C2_BRK.3
unnamed: I2C2.16, I2C2_BRK.4
unnamed: I2C2.14, I2C2_BRK.2
unnamed: I2C2.13, I2C2_BRK.1
unnamed: ANALOG.15, ANALOG_BRK.3
unnamed: ANALOG.16, ANALOG_BRK.4
unnamed: ANALOG.14, ANALOG_BRK.2
unnamed: ANALOG.13, ANALOG_BRK.1
PROG: CHARGE_CONTROLLER.8 (PROG), CHG_R2.1
RF_ANT: ANT_CON.2, U1.9 (ANT)
RF_CLK: BRD1.P1.8 (SPI0_CLK), U1.4 (SCK)
RF_CS: BRD1.P1.6 (SPI0_CS), U1.5 (NSS)
RF_DIO0: BRD1.P2.17 (GPIO_65), U1.14 (DIO0)
RF_DIO1: BRD1.P2.18 (GPIO_47), U1.15 (DIO1)
RF_DIO2: BRD1.P2.19 (GPIO_27), U1.16 (DIO2)
RF_DIO3: BRD1.P2.20 (GPIO_64), U1.11 (DIO3)
RF_DIO4: BRD1.P2.22 (GPIO_46), U1.12 (DIO4)
RF_DIO5: BRD1.P2.24 (GPIO_44), U1.7 (DIO5)
RF_MISO: BRD1.P1.10 (SPI0_MISO), U1.2 (MISO)
RF_MOSI: BRD1.P1.12 (SPI0_MOSI), U1.3 (MOSI)
RF_RST: BRD1.P1.4 (GPIO_89), U1.6 (RESET)
SPI1.2_CS: BRD1.P2.10 (GPIO_52), SPI1.2.9
SPI1.2_GPIO0: BRD1.P1.20 (GPIO_20), SPI1.2.4
SPI1.2_GPIO1: BRD1.P2.28 (PRU0_6), SPI1.2.6
SPI1_CLK: BRD1.P2.29 (SPI1_CLK), SPI1.7, SPI1.2.7
SPI1_CS: BRD1.P2.31 (SPI1_CS), SPI1.9
SPI1_GPIO0: BRD1.P2.2 (GPIO_59), SPI1.4
SPI1_GPIO1: BRD1.P2.3 (GPIO_23), SPI1.6
SPI1_GPIO2: BRD1.P2.4 (GPIO_58), SPI1.8
SPI1_GPIO3: BRD1.P2.6 (GPIO_57), SPI1.10
SPI1_GPIO4: BRD1.P2.8 (GPIO_60), SPI1.12
SPI1_MISO: BRD1.P2.27 (SPI1_MISO), SPI1.5, SPI1.2.5
SPI1_MOSI: BRD1.P2.25 (SPI1_MOSI), SPI1.3, SPI1.2.3
STAT: CHARGE_CONTROLLER.5 (STAT), CHG_R1.1
SWITCH_5V: ALT_SWITCH.3, BAT_PWR.2 (1), BRD1.P1.7 (USB1_VI), PWR_C1.1, PWR_STAT.A, T7.P$1
UART1_GPIO0: BRD1.P1.33 (PRU0_1), UART1.4
UART1_GPIO1: BRD1.P1.31 (PRU0_4), UART1.6
UART1_GPIO2: BRD1.P1.29 (PRU0_7), UART1.8
UART1_GPIO3: BRD1.P1.34 (GPIO_26), UART1.10
UART1_GPIO4: BRD1.P1.35 (PRU1_10), UART1.12
UART1_RX: BRD1.P1.32 (UART0_RX), UART1.5
UART1_TX: BRD1.P1.30 (UART0_TX), UART1.3
UART2_GPIO0/PWM0: ANALOG.3, BRD1.P1.36 (PWM0A), UART2.4
UART2_GPIO1/PWM1: ANALOG.5, BRD1.P2.1 (PWM1A), UART2.6
UART2_RX: BRD1.P2.5 (UART4_RX), UART2.5
UART2_TX: BRD1.P2.7 (UART4_TX), UART2.3
V-: BATTERY_PROTECTION.6 (V-), BAT_R2.2
VBAT2: CHARGE_CONTROLLER.4 (VBAT2)
VCC: ANALOG.1, BRD1.P1.14 (+3V3), BRD1.P2.23 (+3V3), I2C1.1, I2C2.1, RF_C1.1, SPI1.1, SPI1.2.1, T1.P$1, U1.13 (3_3V), UART1.1, UART2.1
VCC_5V: ANALOG.2, BRD1.P1.24 (VOUT), BRD1.P2.13 (VOUT), I2C1.2, I2C2.2, SPI1.2, SPI1.2.2, UART1.2, UART2.2
VDD2: CHARGE_CONTROLLER.2 (VDD2)
V_USB: CHARGE_CONTROLLER.1 (VDD), CHG_C1.1, CHG_STAT.A, J1.1 (VUSB), T3.P$1

Notes on the sheet:
Note: SPI1.2_CS isn't a part of the PocketBeagle SPI bus. A GPIO pin is used as this chip-select, in an attempt to have more SPI devices
LI-PO POWER
EXPANSION PORTS
9V POWER
POCKET-BEAGLE
RICE ECLIPSE REAL TIME ROCKET TRANSMITTER REV 1
IMPORTANT: Turn off Switch BEFORE plugging in USB! Not following this could severely damage the board!

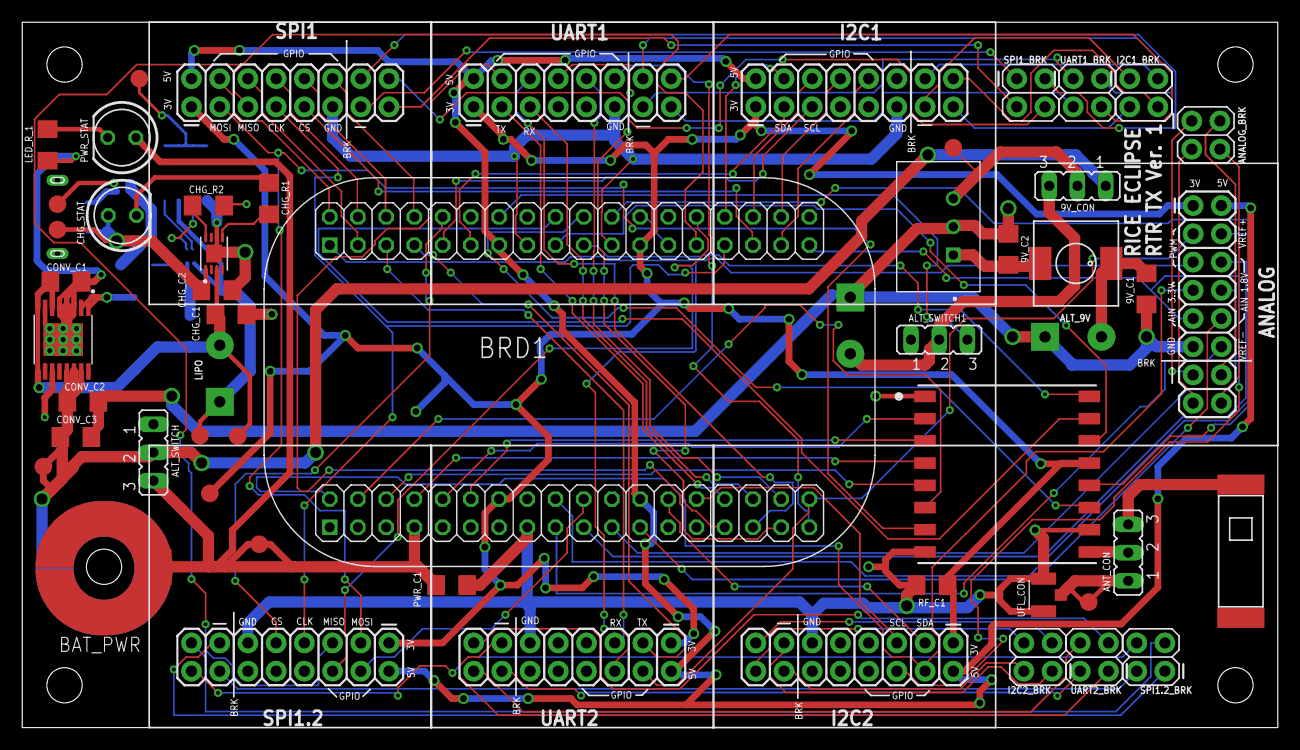
[picture p20: board Electro Transmitter Rev 1 copy.brd from above]

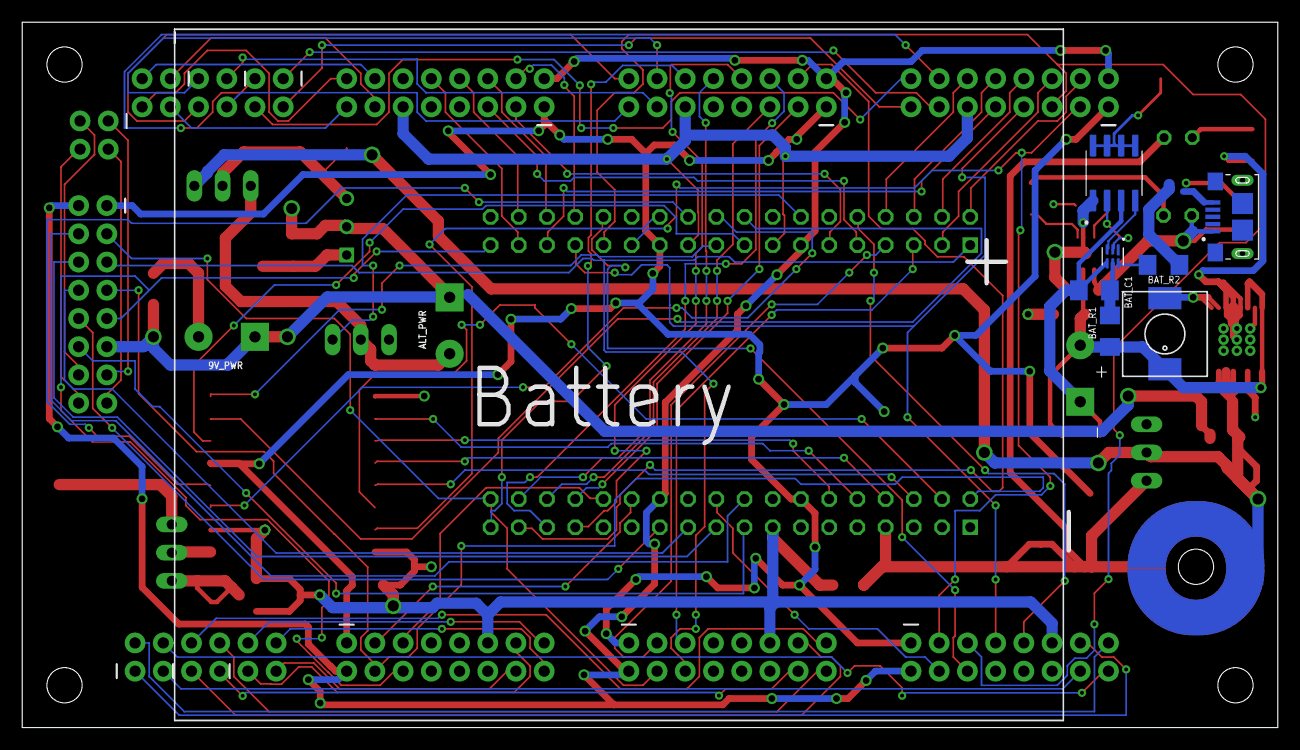
[picture p21: board Electro Transmitter Rev 1 copy.brd from below]

Board: 2 copper layers, 113.0 x 63.5 mm, 62 parts (9 on the bottom side), 103 nets.

Other parts of the board:
U$1: 5000MAH_LI-PO_BATTERY
