rice-eclipse/Real-Time-Rocket/Neutro_documentation/Neutro Kicad Symbol Footprint/LiPoChargerBooster5V1A_v10_1/LiPoChargerBooster5V1A_v10.brd

## EAGLE design Neutro_documentation/Neutro Kicad Symbol Footprint/LiPoChargerBooster5V1A_v10_1/LiPoChargerBooster5V1A_v10.brd (2023-06-26)

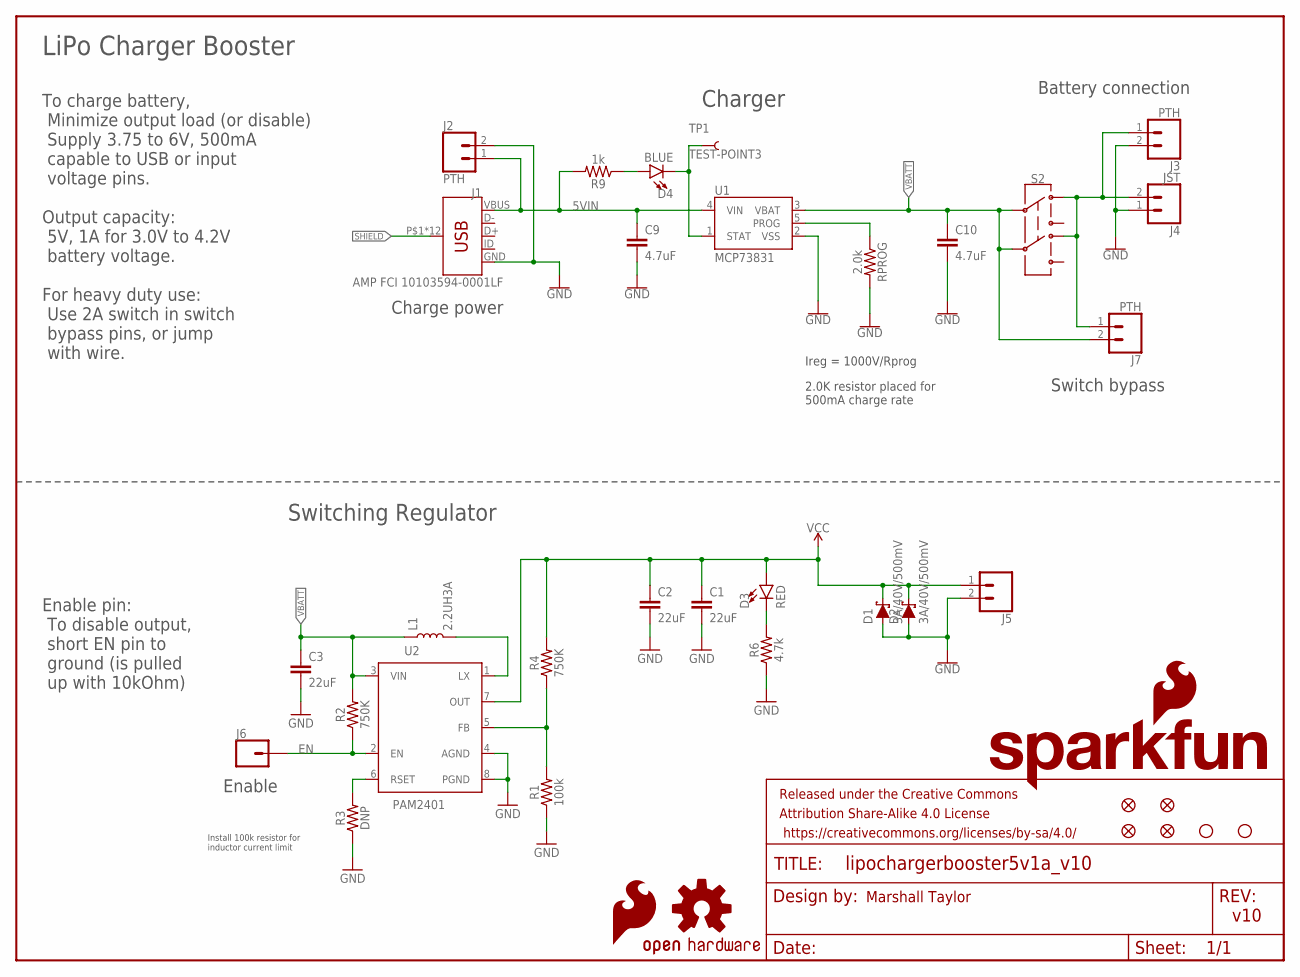
[picture p22: schematic LiPoChargerBooster5V1A_v10.sch]

Parts:
C1, C2, C3: 22uF; 0805
C9, C10: 4.7uF; 0603
D1, D2: 3A/40V/500mV; SMA-DIODE
D3: RED; LED-0603
D4: BLUE; LED-0603
FRAME1: FRAME-LETTER; CREATIVE_COMMONS
J1: AMP FCI 10103594-0001LF; USB-MICROB-PTH
J2, J3, J7: PTH; 1X02
J4: JST; JST-2-SMD
J5: CONN_02; 1X02
J6: CONN_01; 1X01
JP1, JP2, JP4, JP16: FIDUCIAL1X2; FIDUCIAL-1X2
JP3: SFE_LOGO_NAME_FLAME.1_INCH; SFE_LOGO_NAME_FLAME_.1
JP6, JP7: STAND-OFF
L1: 2.2UH3A; INDUCTOR_4X4MM
LOGO1: SFE_LOGO_FLAME.1_INCH; SFE_LOGO_FLAME_.1
R1: 100k; 0603
R2, R4: 750K; 0603
R3: DNP; 0603
R6: 4.7k; 0603
R9: 1k; 0603
RPROG: 2.0k; 0603
S2: SWITCH-DPDT-SMD-AYZ0202; SWITCH_DPDT_SMD_AYZ0202
TP1: TEST-POINT3; PAD.03X.03
U1: MCP73831; SOT23-5
U2: PAM2401; MSOP8
U$1: OSHW-LOGOS; OSHW-LOGO-S

Connections:
5VIN: C9.1, J1.VBUS, J2.1, R9.2, U1.4 (VIN)
EN: J6.1, R2.1, U2.2 (EN)
GND: C1.2, C2.2, C3.2, C9.2, C10.2, D1.A, D2.A, J1.GND, J2.2, J3.2, J4.1 (2), J5.2, R1.1, R3.1, R6.1, RPROG.2, U1.2 (VSS), U2.4 (AGND), U2.8 (PGND)
unnamed: D3.C, R6.2
unnamed: D4.A, R9.1
unnamed: L1.P$2 (2), U2.1 (LX)
unnamed: R3.2, U2.6 (RSET)
unnamed: J3.1, J4.2 (1), J7.1, S2.1, S2.4
unnamed: RPROG.1, U1.5 (PROG)
unnamed: R1.2, R4.1, U2.5 (FB)
unnamed: D4.C, TP1.P$1, U1.1 (STAT)
SHIELD: J1.P$1 (SHIELD), J1.P$2 (SHIELD), J1.P$3 (SHIELD), J1.P$4 (SHIELD), J1.P$6 (SHIELD), J1.P$8 (SHIELD), J1.P$10 (SHIELD), J1.P$12 (SHIELD), J1.SHEILD2 (SHIELD), J1.SHIELD, J1.SHIELD3 (SHIELD), J1.SHIELD4 (SHIELD)
VBATT: C3.1, C10.1, J7.2, L1.P$1 (1), R2.2, S2.2, S2.5, U1.3 (VBAT), U2.3 (VIN)
VCC: C1.1, C2.1, D1.C, D2.C, D3.A, J5.1, R4.2, U2.7 (OUT)

Notes on the sheet:
Charger
Switching Regulator
Marshall Taylor
v10
2.0K resistor placed for 500mA charge rate
Ireg = 1000V/Rprog
To charge battery, Minimize output load (or disable) Supply 3.75 to 6V, 500mA capable to USB or input voltage pins.
Install 100k resistor for inductor current limit
LiPo Charger Booster
Output capacity: 5V, 1A for 3.0V to 4.2V battery voltage.
Enable pin: To disable output, short EN pin to ground (is pulled up with 10kOhm)
Enable
Charge power
Battery connection
Switch bypass
For heavy duty use: Use 2A switch in switch bypass pins, or jump with wire.

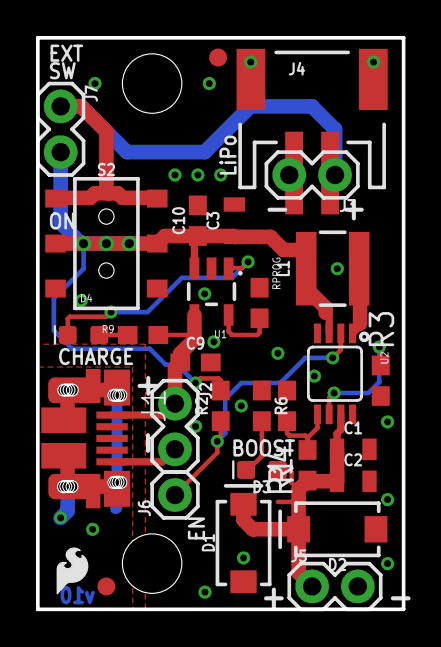
[picture p23: board LiPoChargerBooster5V1A_v10.brd from above]

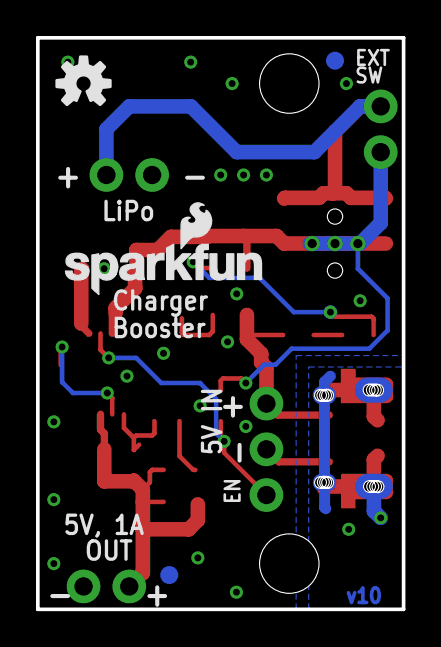
[picture p24: board LiPoChargerBooster5V1A_v10.brd from below]

Board: 2 copper layers, 20.3 x 31.8 mm, 38 parts (5 on the bottom side), 14 nets.
