rice-eclipse/Real-Time-Rocket/Neutro_documentation/ElectroII Python Code copy/python/i2ctest.py

import smbus2
import time
# for RPI version 1, use "bus = smbus.SMBus(0)"
bus = smbus2.SMBus(1)

# This is the address we setup in the Arduino Program
address = 0x29

def writeNumber(value):
    bus.write_byte(address, value)
    # bus.write_byte_data(address, 0, value)
    return -1

def readNumber():
    number = bus.read_byte(address)
    # number = bus.read_byte_data(address, 1)
    return number

while True:
    print(bus.read_byte(address))
    time.sleep(0.1)
