rice-eclipse/Real-Time-Rocket/(commit log)

2018-11-08 Added barebones transmission test for certs
    Just transmits incrementing numbers as fast as possible and logs to
    local SD. Receiver prints values to serial but does not log to any
    external source yet. Kept original factory examples in Examples folder.
2018-11-08 Added pressure/altitude/temperature sensor
2018-11-09 Created a local logging script
    Alternative to simply copy-pasting from Arduino serial monitor.
    Requires the Processing language to be installed. Put it on Hammer,
    might come in handy for the certs test.
2019-03-01 Changed pin definitions to keep consistent with Transmitter code
2019-08-16 Add battery holder library file
2019-08-20 Add main RTR schematic (missing extra Li-Po power circuitry)
    [Transmitter Rev 1.sch]
2019-08-22 Finalize schematic
    [Transmitter Rev 1.sch]
2019-08-22 Add power circuitry libraries and update part footprints
2019-08-22 Update datasheets, small schematic revisions, add test pins
    [Transmitter Rev 1.sch]
2019-08-24 Lay out components logically on board, miscellaneous library and schematic additions and fixes
    [Transmitter Rev 1.brd, Transmitter Rev 1.sch]
2019-08-30 Route Board
    [Transmitter Rev 1.brd, Transmitter Rev 1.sch]
2019-08-31 Increase size of and reroute VCC and VCC_5V traces throughout the board
    [Transmitter Rev 1.brd]
2019-08-31 Update EAGLE version and small miscellaneous documentation/functionality fixes
    [Transmitter Rev 1.brd, Transmitter Rev 1.sch]
2019-09-14 Added IMU datasheet
2019-10-12 Update libraries and add all sensor support
2019-10-16 Add zero calibration
2019-10-16 Add Kevin's Transciever breakout board
    [Transceiver.brd, Transceiver.sch]
2019-10-16 Update names
    [Electro Transmitter Rev 1.brd, Electro Transmitter Rev 1.sch]
2019-10-16 Add PCB Mill Design Rules
2019-11-07 Add IMU sensor library and support
2019-11-09 Add IMU Library
2020-01-19 Add extra characters so message not cut off
2020-02-23 Add remaining Sensor Breakout Boards
    [Altimeter.brd, Altimeter.sch, IMU Breakout Board.brd, IMU Breakout Board.sch, M20050-1 GPS Breakout Board.brd, M20050-1 GPS Breakout Board.sch]
2021-02-21 start updated gps breakout
    [M20050-1 GPS Breakout Board 2.brd, M20050-1 GPS Breakout Board 2.sch]
2021-02-28 Tested I2C
2021-03-08 IMU_BNO085_Schematic
    Beginning work
    [IMU_BNO085_Schematic.sch]
2021-03-09 Revised IMU schematic and roughed out board
    [IMU_BNO085_Schematic.brd, IMU_BNO085_Schematic.sch]
2021-03-10 Laid out board + redid library for BNO
    [IMU_BNO085_Schematic.brd, IMU_BNO085_Schematic.sch]
2021-03-10 Cleaned up board, see Cleanup files
    [IMU_BNO085_Schematic_Cleanup.brd, IMU_BNO085_Schematic_Cleanup.sch]
2021-03-22 Schematic for BNO055
    [BNO055_SCH.sch, IMU_BNO085_Schematic.sch]
2021-03-22 Updated Sketch
    [BNO055_SCH.sch]
2021-04-04 GPS2 schematic
    [Electro Transmitter Rev 1.brd, Electro Transmitter Rev 1.sch, M20050-1 GPS Breakout Board 2.brd, M20050-1 GPS Breakout Board 2.sch]
2021-04-04 first draft of gps breakout 2
    [M20050-1 GPS Breakout Board 2.brd]
2021-04-11 finish gpsv2
    [M20050-1 GPS Breakout Board 2.brd, M20050-1 GPS Breakout Board 2.sch]
2021-04-14 actually updated the imu board, might want to check clearance before shipping it out
    [BNO055_SCH.brd, BNO055_SCH.sch]
2021-08-27 **NEW AND IMPROVED**
    new and improved versions for a 2021 fall
    [Altimeter.brd]
2021-08-27 gps for fabrication
    [M20050-1 GPS Breakout Board 2.brd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]
2021-10-26 update gps to work with smaller inductor
    [M20050-1 GPS Breakout Board 2.brd, M20050-1 GPS Breakout Board 2.sch]
2022-02-07 fix standby and gnd gps
    [IMU_BNO085_Schematic.brd, IMU_BNO085_Schematic.sch, IMU_BNO085_Schematic_Cleanup.brd, IMU_BNO085_Schematic_Cleanup.sch, M20050-1 GPS Breakout Board 2.sch]
2022-11-10 made changes to schematic, see schematic notes doc in drive
    [Altimeter.brd, Altimeter.sch, BNO055_SCH.brd, BNO055_SCH.sch, Electro Transmitter Rev 1.brd, Electro Transmitter Rev 1.sch, IMU Breakout Board.brd, IMU Breakout Board.sch]
2022-11-18 update 11_17
    [avio_flight_instruments_meeting_1.kicad_pcb, avio_flight_instruments_meeting_1.kicad_sch]
2022-11-23 Added layout version 1 11_23_22
    [avio_flight_instruments_meeting_1.kicad_pcb, avio_flight_instruments_meeting_1.kicad_sch]
2022-12-02 Neutro layout revision 12.2.22
    [avio_flight_instruments_meeting_1.kicad_pcb, avio_flight_instruments_meeting_1.kicad_sch]
2022-12-04 neutro layout update 12.4.22
    [avio_flight_instruments_meeting_1.kicad_pcb]
2022-12-05 layout revision 12.4.22
    [avio_flight_instruments_meeting_1.kicad_pcb]
2022-12-24 Revision 12.24.22
    [avio_flight_instruments_meeting_1.csv, avio_flight_instruments_meeting_1.kicad_pcb, avio_flight_instruments_meeting_1.kicad_sch]
2023-01-21 neutro pcb v1 final design 1.21.22
    [Neutro_v1.kicad_pcb, Neutro_v1.kicad_sch]
2023-01-21 neutro v1 1.21.23 final pcb (change L2, L3 size)
    [Neutro_v1-B_Cu.gbl, Neutro_v1-B_Mask.gbs, Neutro_v1-B_Paste.gbp, Neutro_v1-B_Silkscreen.gbo, Neutro_v1-Edge_Cuts.gm1, Neutro_v1-F_Cu.gtl, Neutro_v1-F_Mask.gts, Neutro_v1-F_Paste.gtp]
2023-01-22 1.22.23 final neutro v1 pcb
    [Neutro_v1.kicad_pcb]
2023-01-23 added electroII code
    [BATT-S8411-45R.step, BNO085.PcbLib, BNO085.SchLib, BNO085.stp, DS3231M+TRL.step, EDI2CAP.CFG, M20050-1.SchLib, M20050-1.stp]
2023-02-27 verified BOM
    [Neutro_v1.csv]
2023-06-26 added folder for supplementary files such as JLC order setting, datasheets, and KICAD symbol footprint files
    [Altimeter update.kicad_sch, BNO080.step, DS3231M_TRL.step, Electro Transmitter Rev 1 copy.brd, Electro Transmitter Rev 1 copy.sch, IMU_Update.kicad_sch, LiPoChargerBooster5V1A_v10.brd, LiPoChargerBooster5V1A_v10.sch]
